craigyjp/PolyKit-16/photos/20230112_212233.jpg

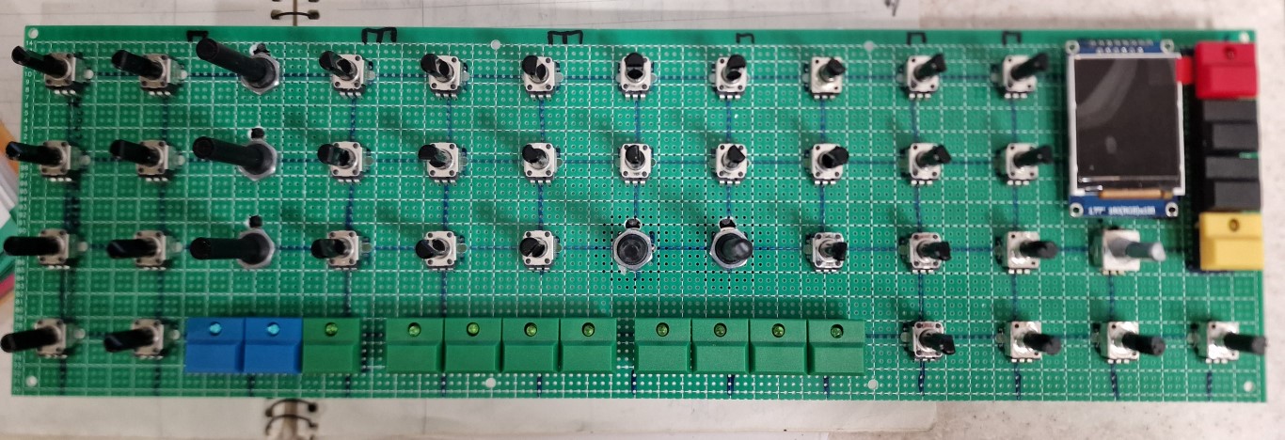
photos/20230112_212233.jpg
