craigyjp/PolyKit-16/photos/20230113_110707.jpg

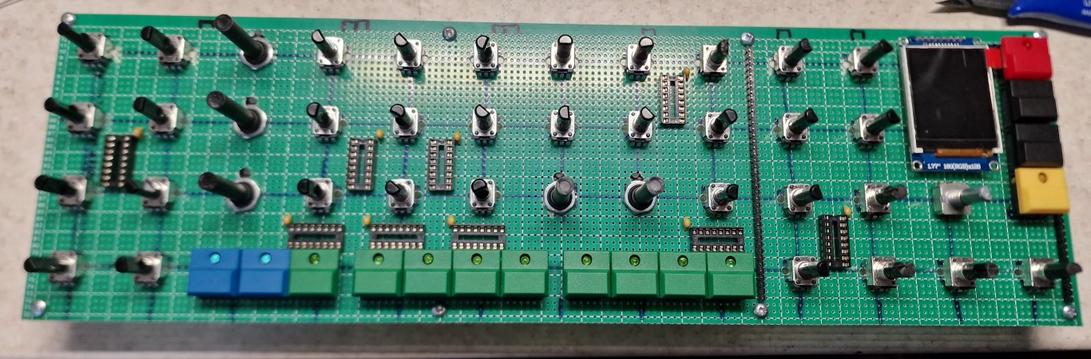
photos/20230113_110707.jpg
