craigyjp/PolyKit-16/photos/20230113_140341.jpg

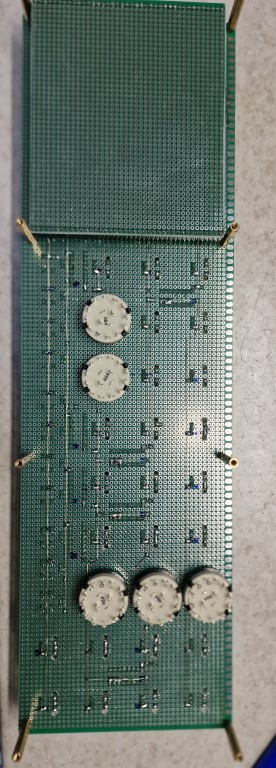
photos/20230113_140341.jpg
