craigyjp/PolyKit-16/photos/20230113_140354.jpg

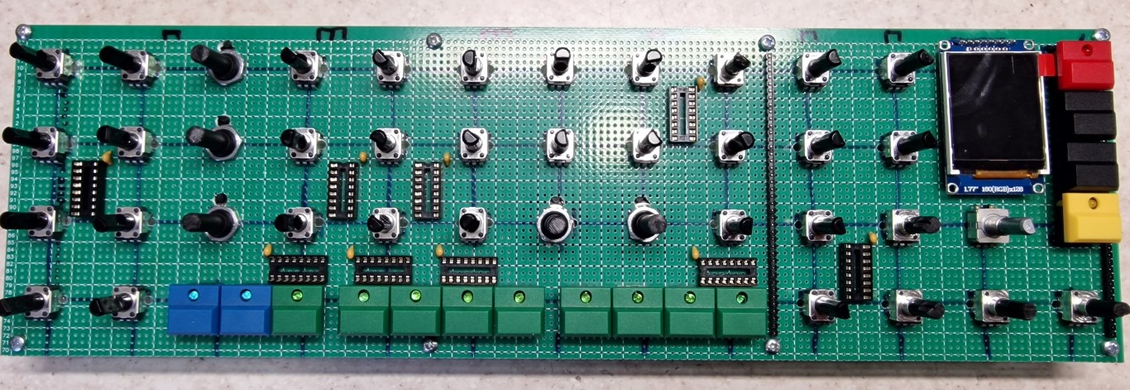
photos/20230113_140354.jpg
