craigyjp/PolyKit-16/photos/20230113_140404.jpg

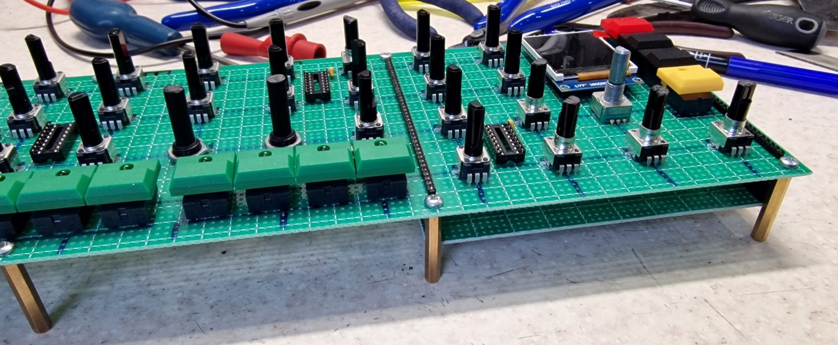
photos/20230113_140404.jpg
