craigyjp/PolyKit-16/photos/20230115_155945.jpg

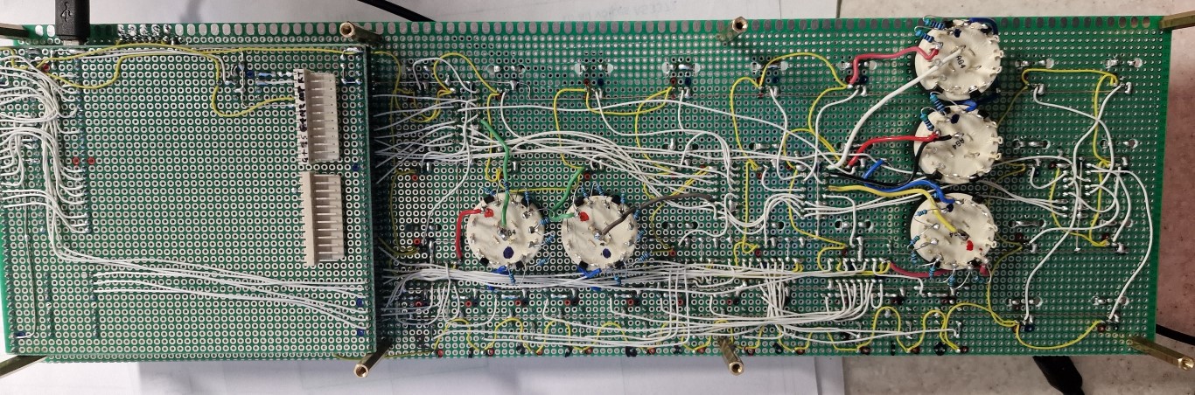
photos/20230115_155945.jpg
