craigyjp/PolyKit-16/photos/20230115_155958.jpg

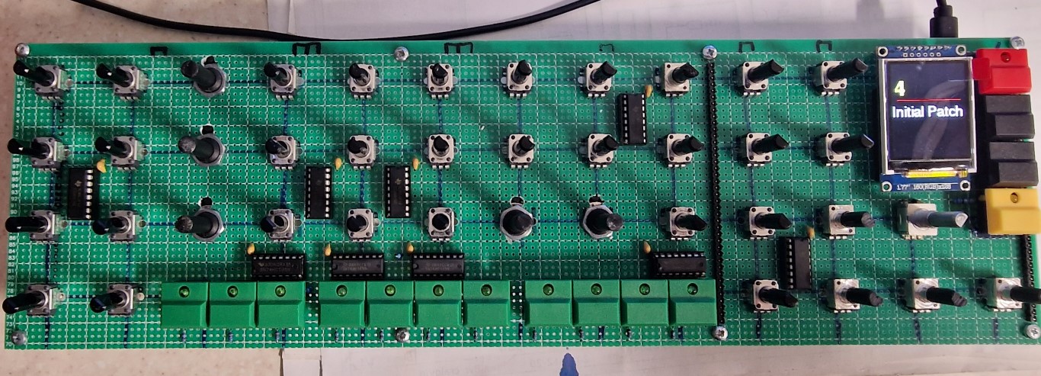
photos/20230115_155958.jpg
