craigyjp/PolyKit-16/photos/20230119_172531.jpg

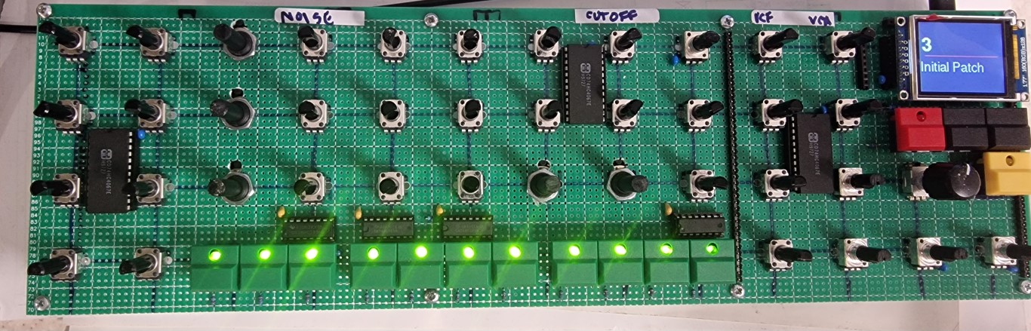
photos/20230119_172531.jpg
