craigyjp/PolyKit-16/photos/20230120_211841.jpg

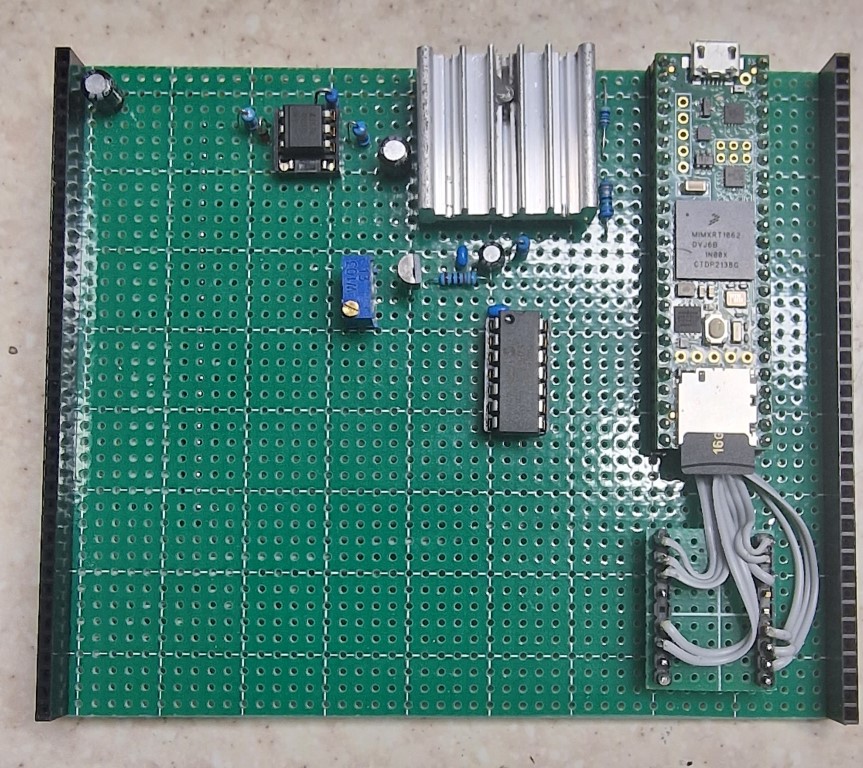
photos/20230120_211841.jpg
