craigyjp/PolyKit-16/photos/20230121_161446.jpg

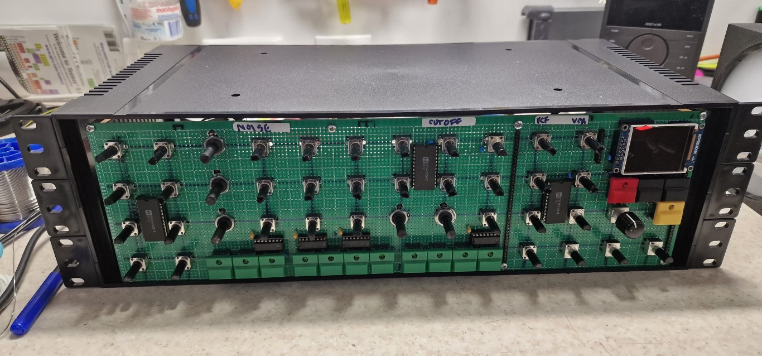
photos/20230121_161446.jpg
