craigyjp/PolyKit-16/photos/20230121_161559.jpg

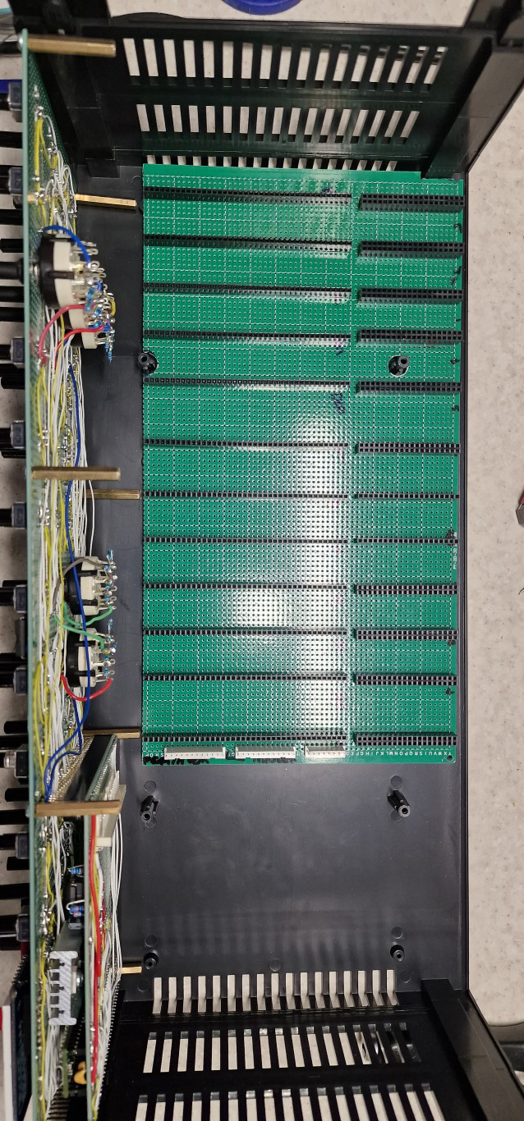
photos/20230121_161559.jpg
