craigyjp/PolyKit-16/photos/20230121_221155.jpg

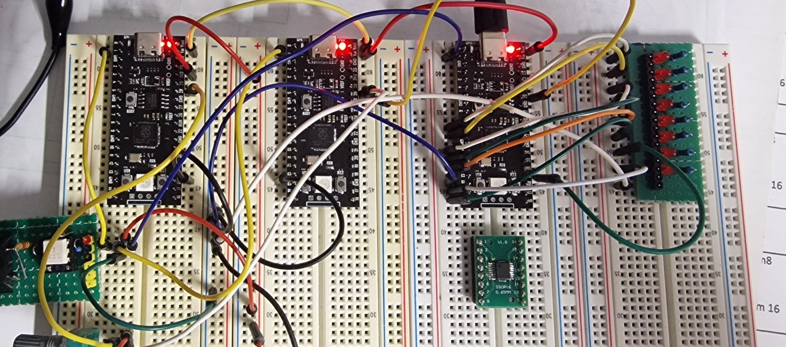
photos/20230121_221155.jpg
