craigyjp/PolyKit-16/photos/20230122_144658.jpg

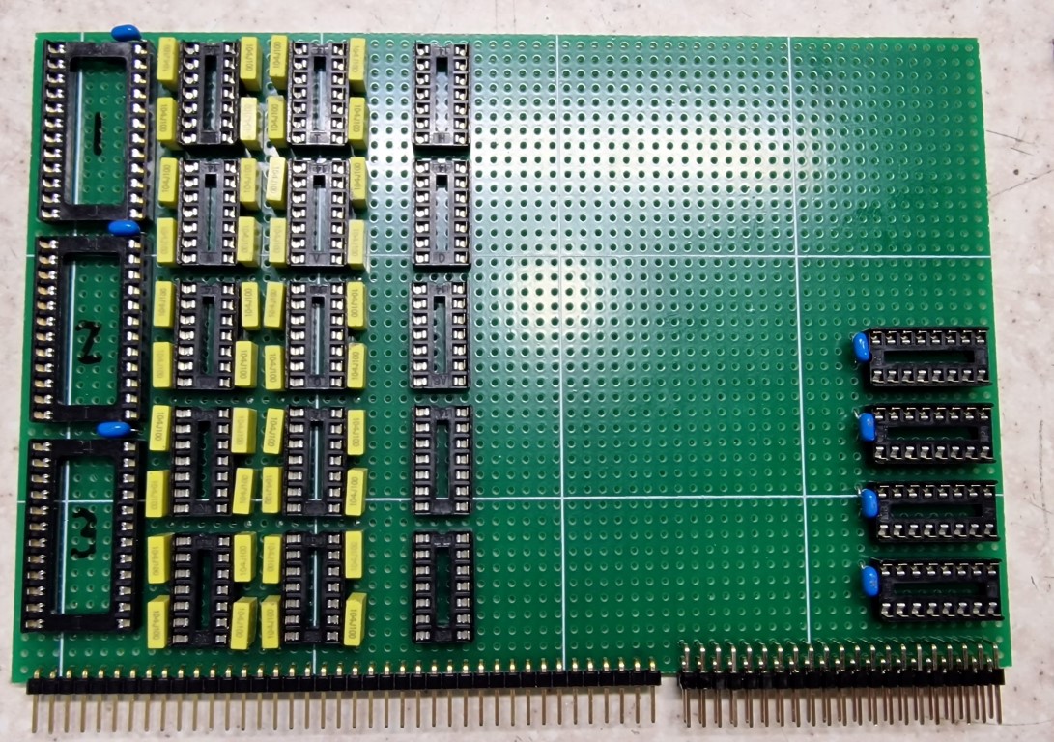
photos/20230122_144658.jpg
