craigyjp/PolyKit-16/photos/20230122_203301.jpg

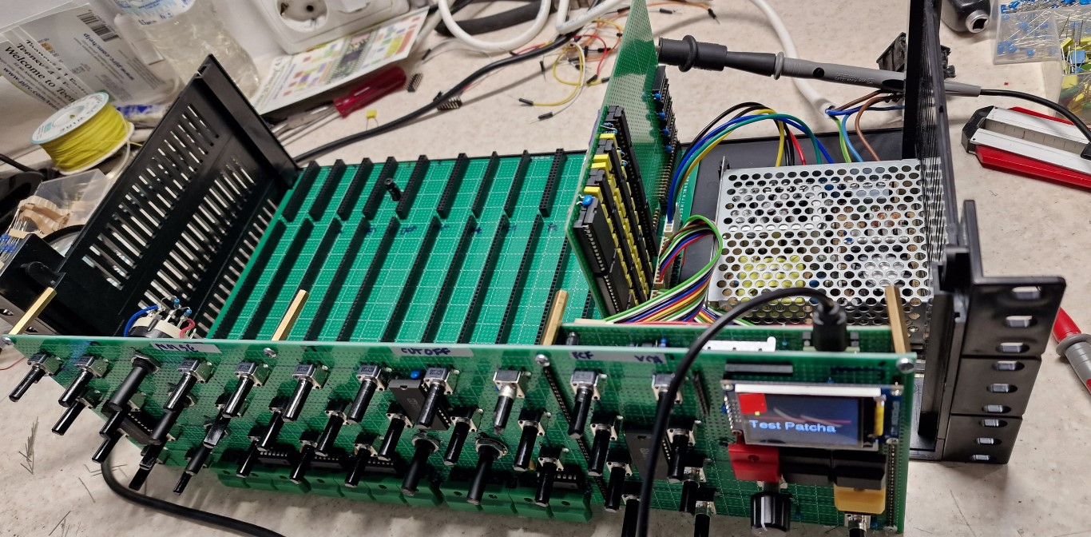
photos/20230122_203301.jpg
