craigyjp/PolyKit-16/photos/20230123_171128.jpg

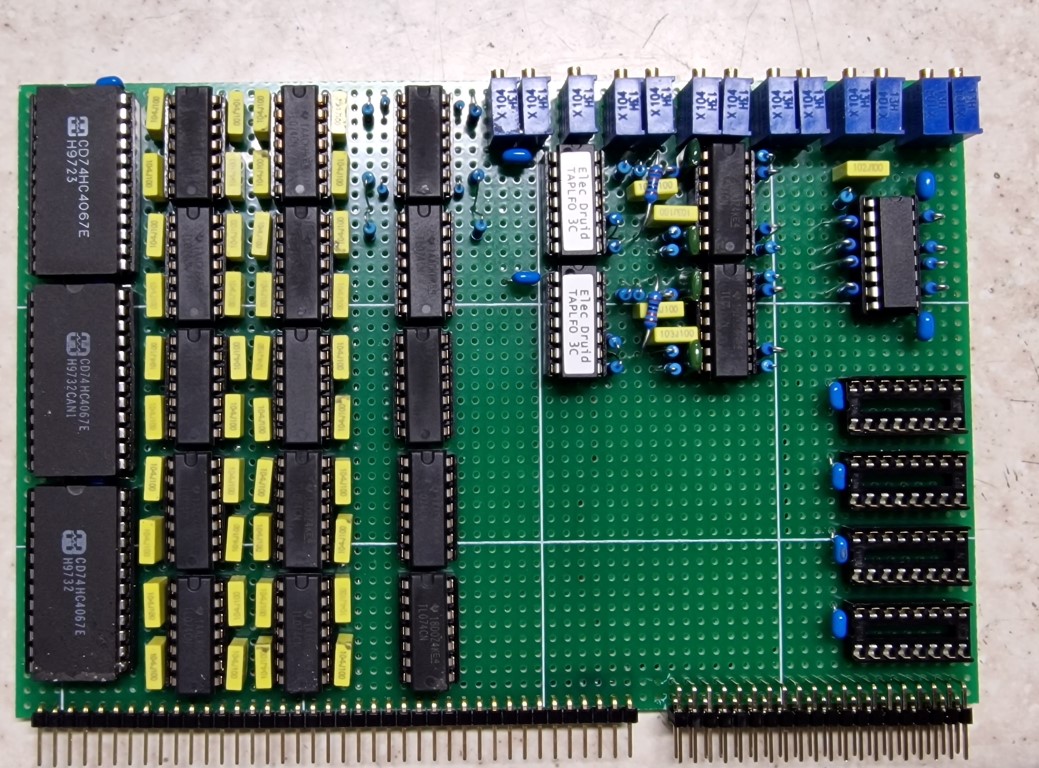
photos/20230123_171128.jpg
