craigyjp/PolyKit-16/photos/20230123_171157.jpg

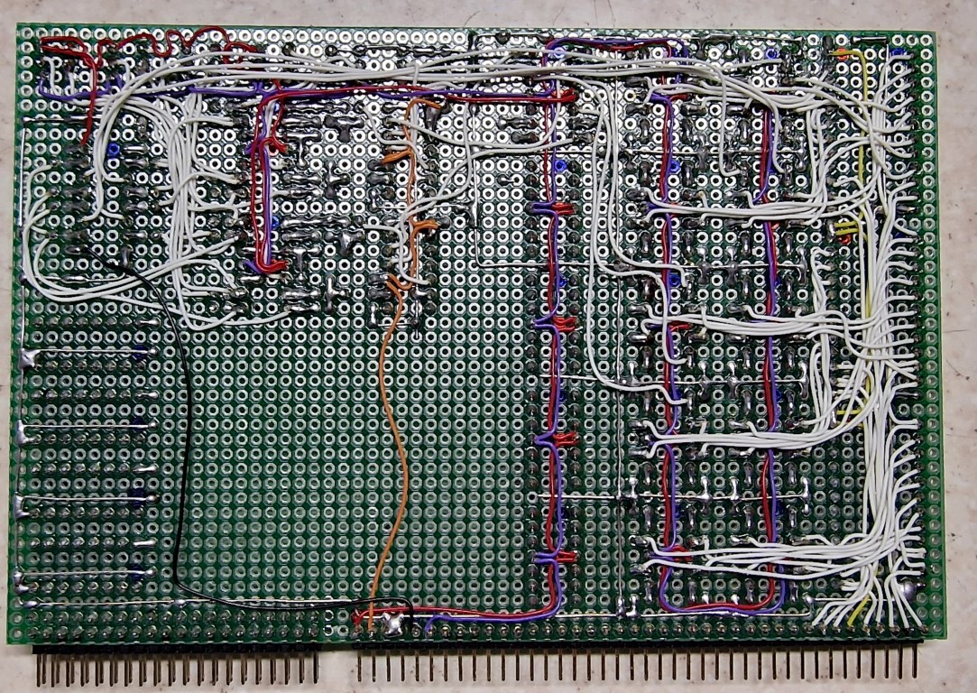
photos/20230123_171157.jpg
