craigyjp/PolyKit-16/photos/20230123_195308.jpg

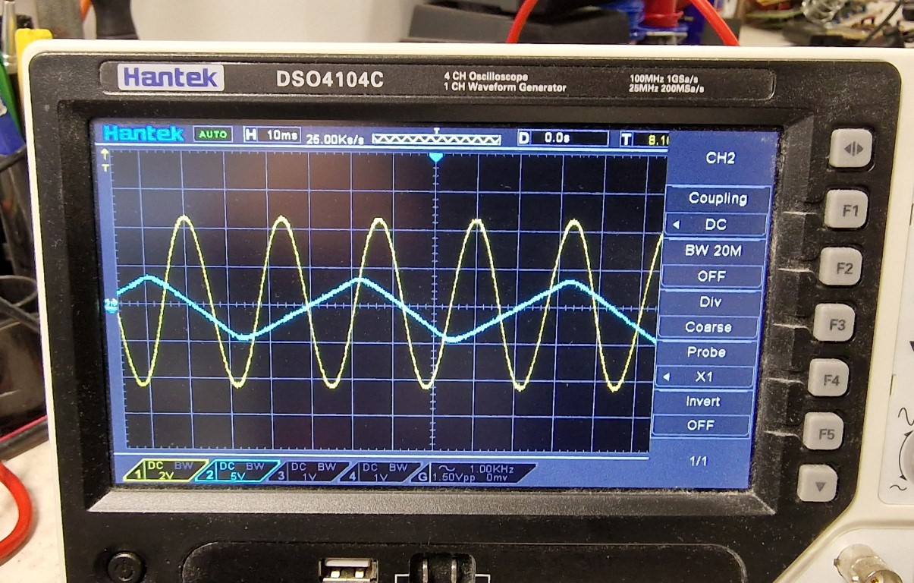
photos/20230123_195308.jpg
