craigyjp/PolyKit-16/photos/20230123_204247.jpg

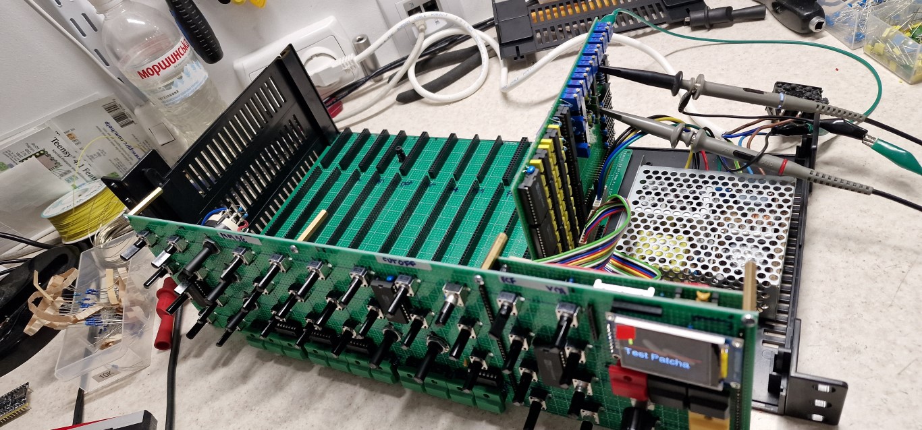
photos/20230123_204247.jpg
