craigyjp/PolyKit-16/photos/20230123_204253.jpg

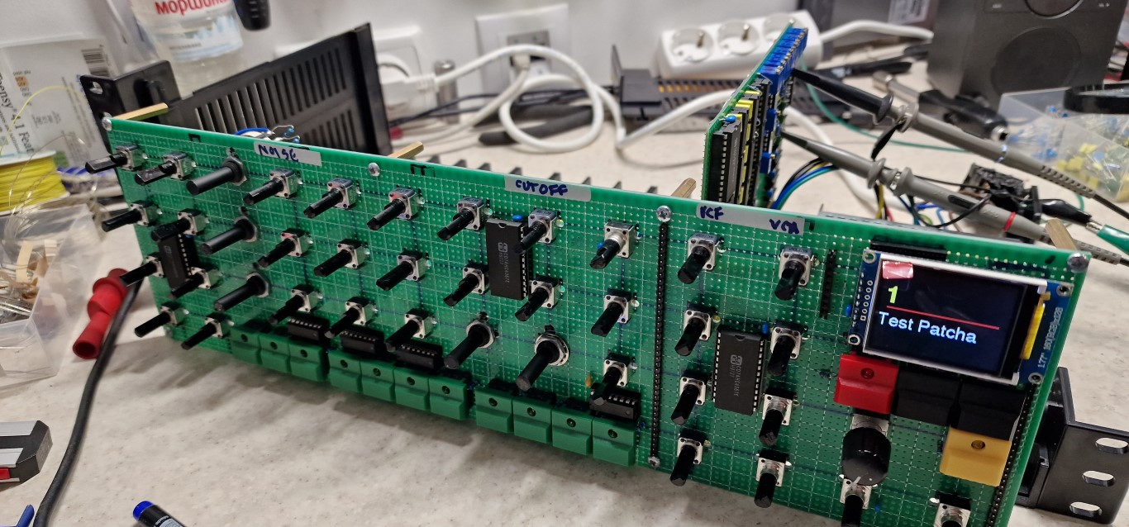
photos/20230123_204253.jpg
