craigyjp/PolyKit-16/photos/20230124_180600.jpg

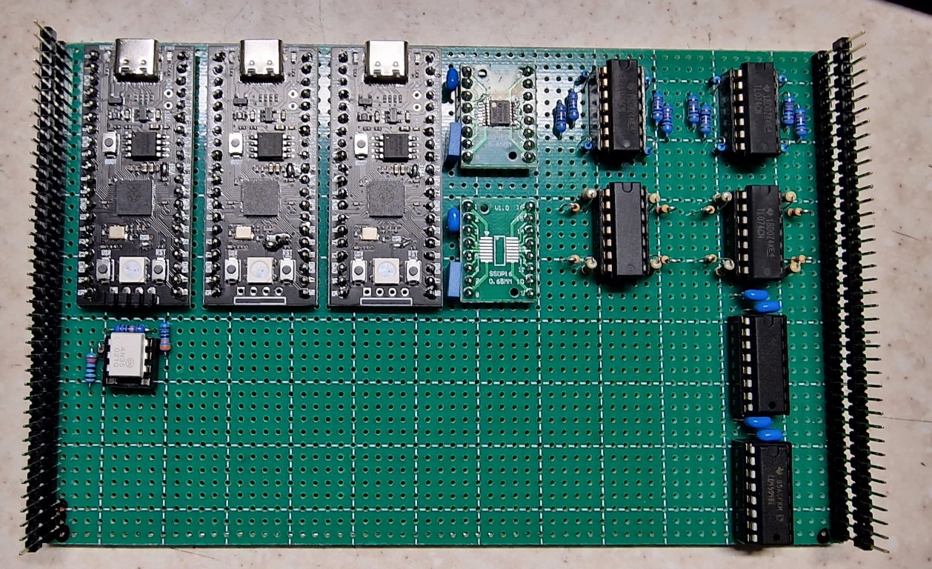
photos/20230124_180600.jpg
