craigyjp/PolyKit-16/photos/20230124_181016.jpg

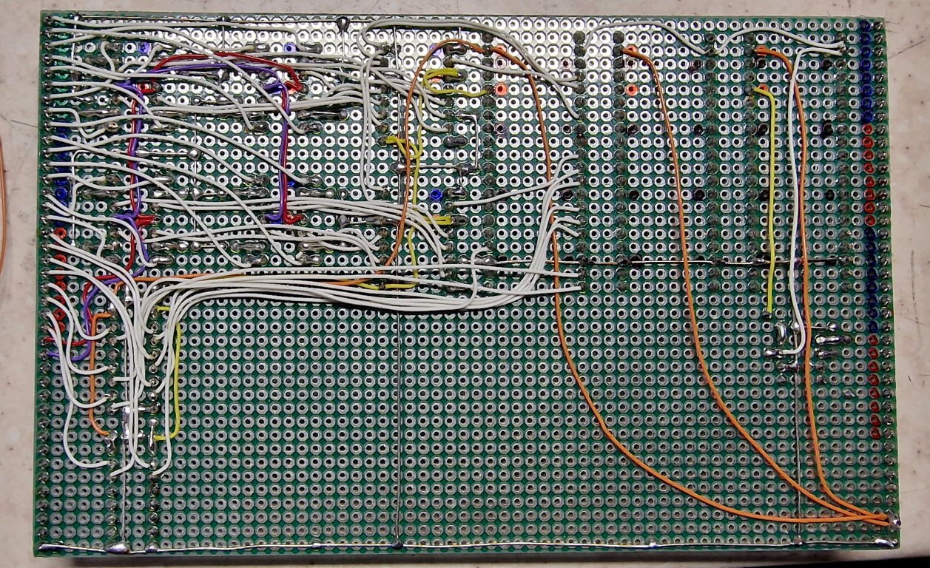
photos/20230124_181016.jpg
