craigyjp/PolyKit-16/photos/20230125_140616.jpg

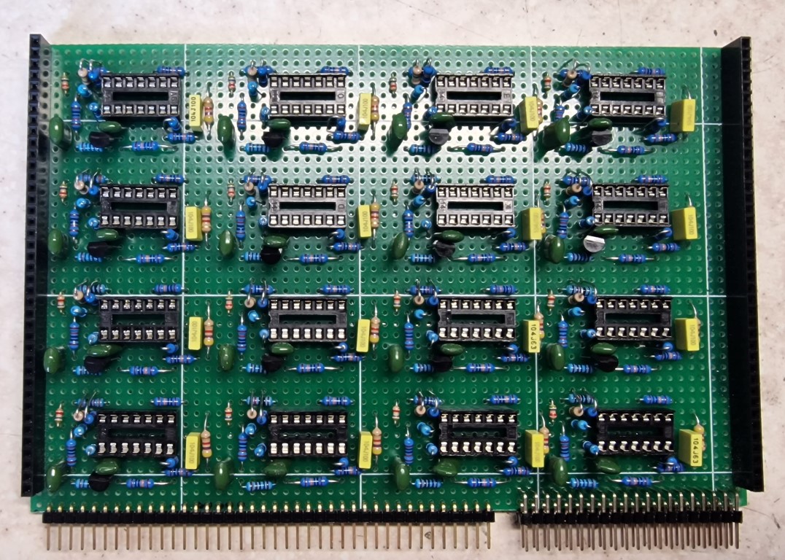
photos/20230125_140616.jpg
