craigyjp/PolyKit-16/photos/20230125_140625.jpg

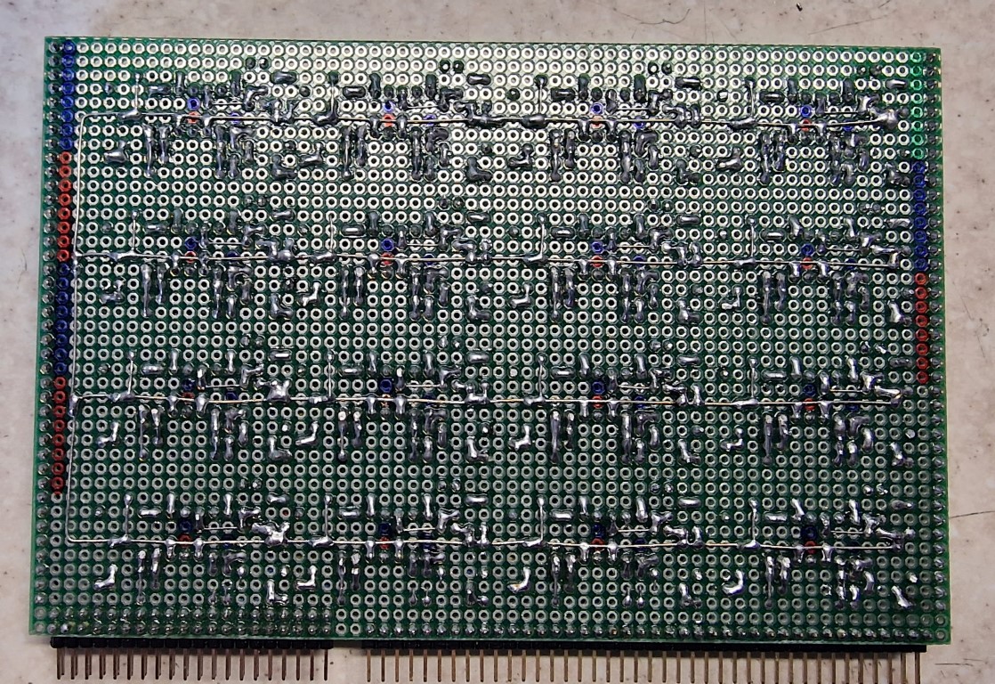
photos/20230125_140625.jpg
