craigyjp/PolyKit-16/photos/20230125_160724.jpg

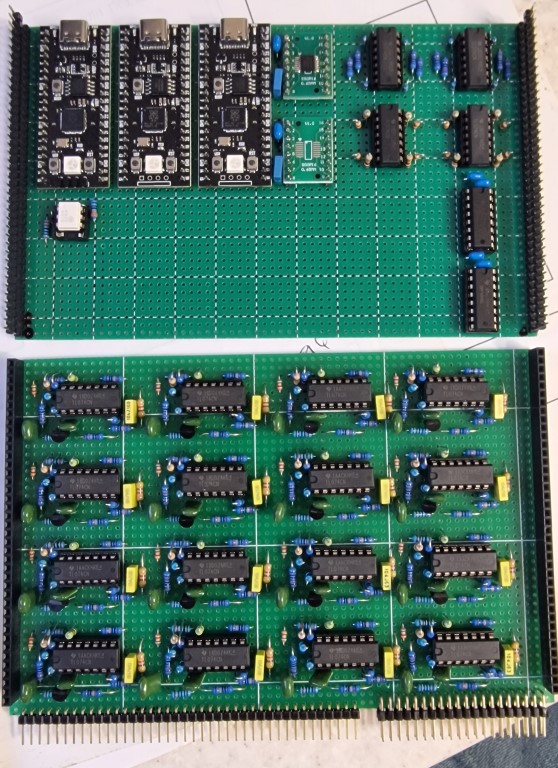
photos/20230125_160724.jpg
