craigyjp/PolyKit-16/photos/20230125_203501.jpg

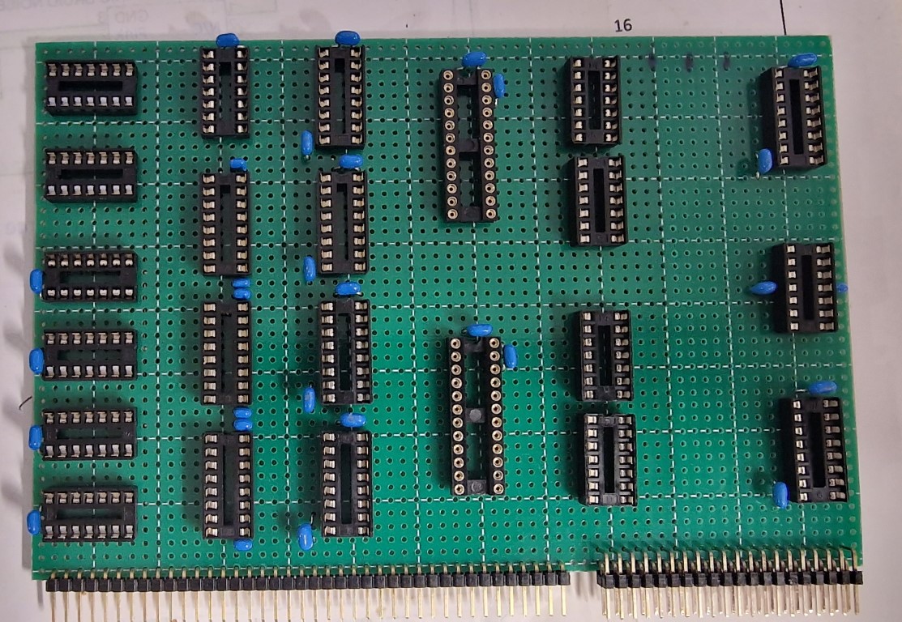
photos/20230125_203501.jpg
