craigyjp/PolyKit-16/photos/20230126_164155.jpg

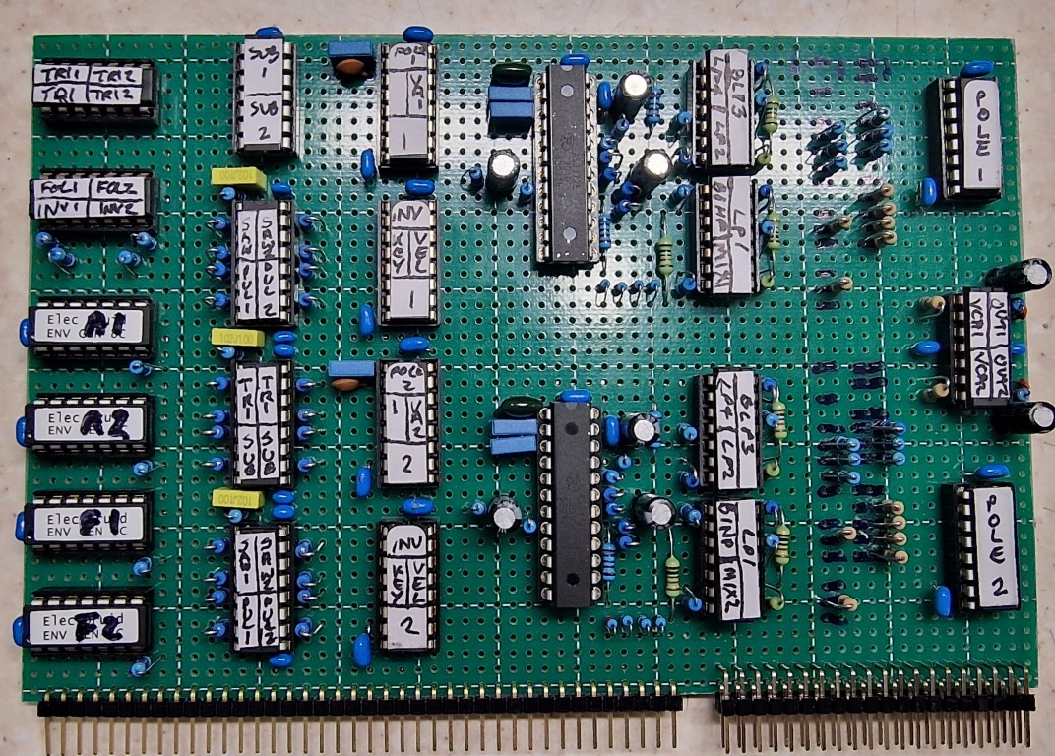
photos/20230126_164155.jpg
