craigyjp/PolyKit-16/photos/20230129_130145.jpg

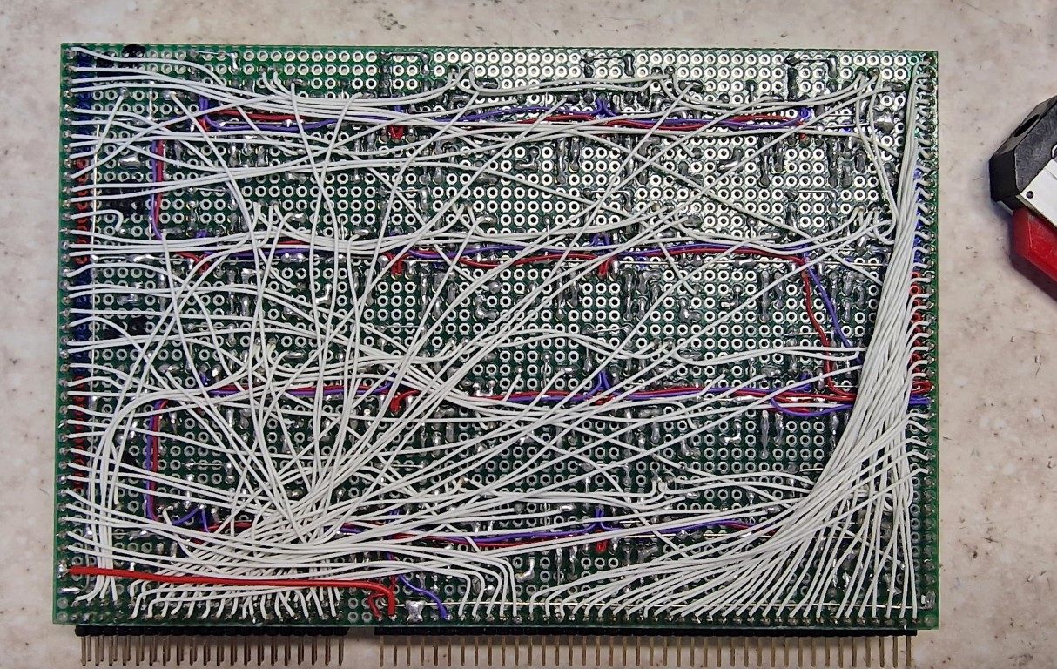
photos/20230129_130145.jpg
