craigyjp/PolyKit-16/photos/20230129_132823.jpg

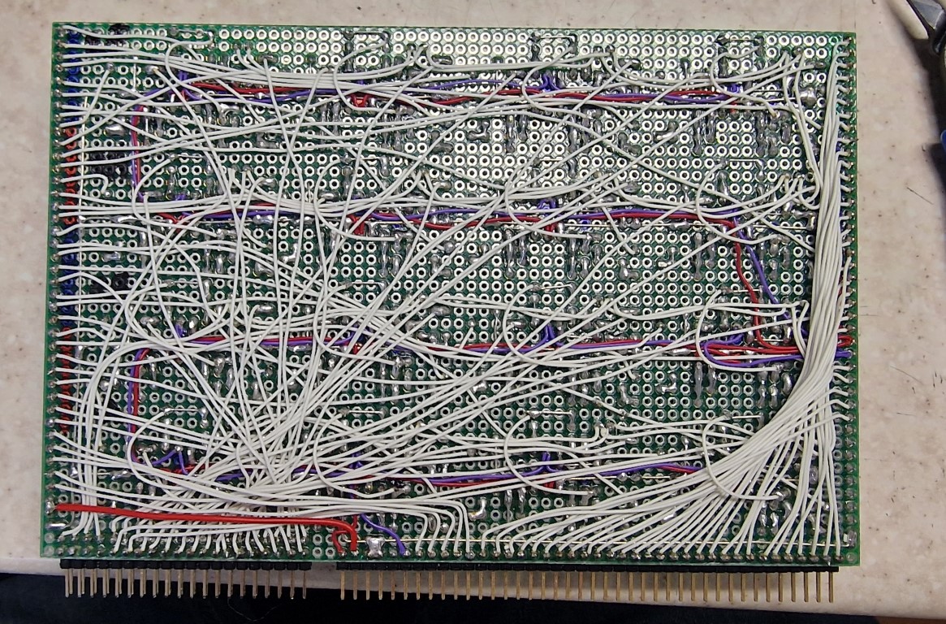
photos/20230129_132823.jpg
