craigyjp/PolyKit-16/photos/20230129_185415.jpg

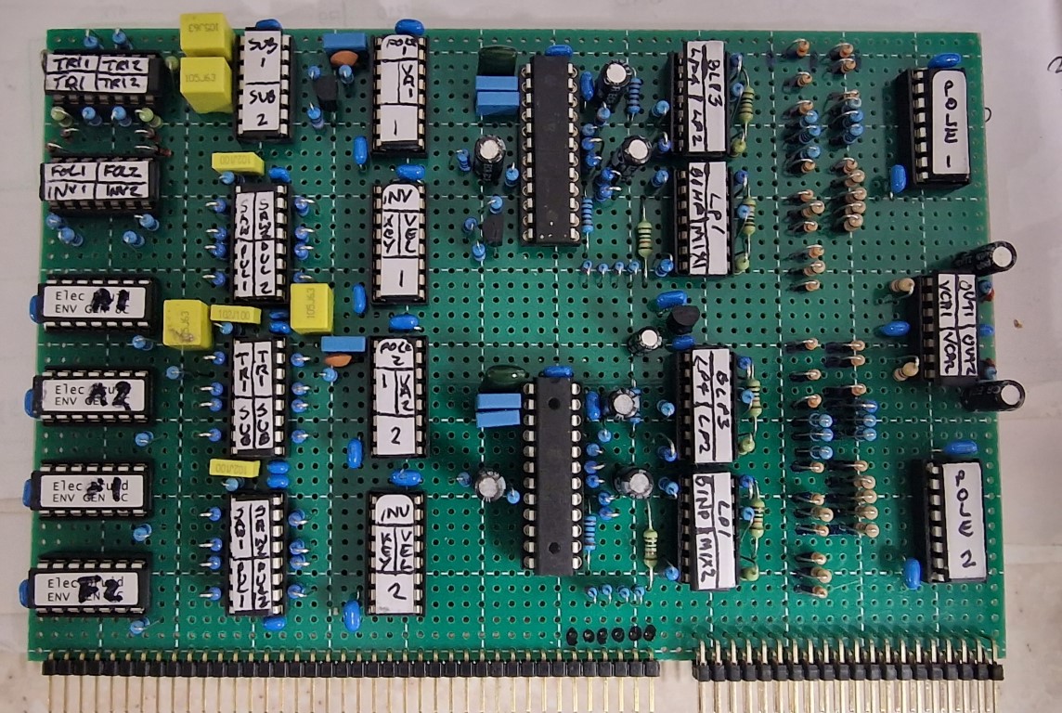
photos/20230129_185415.jpg
