craigyjp/PolyKit-16/photos/20230129_185424.jpg

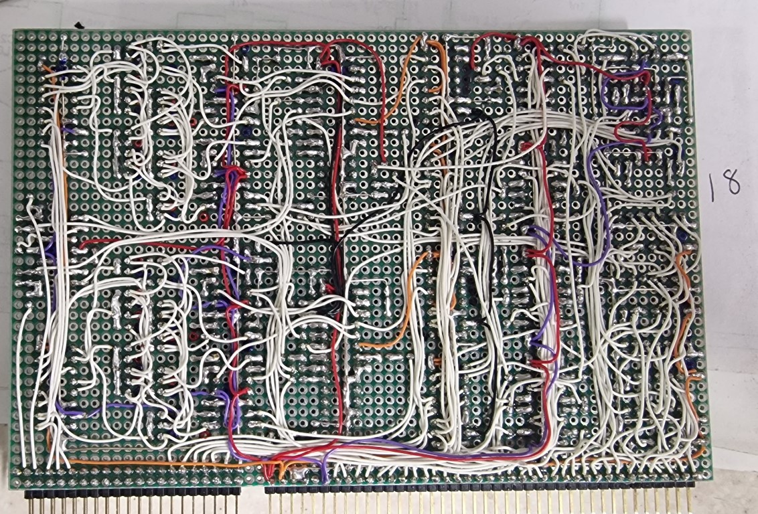
photos/20230129_185424.jpg
