craigyjp/PolyKit-16/photos/20230129_200219.jpg

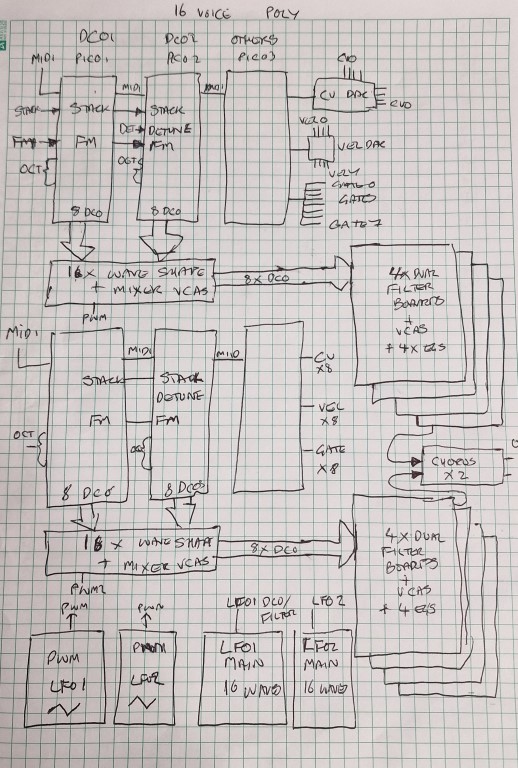
photos/20230129_200219.jpg
