craigyjp/PolyKit-16/photos/20230201_124814.jpg

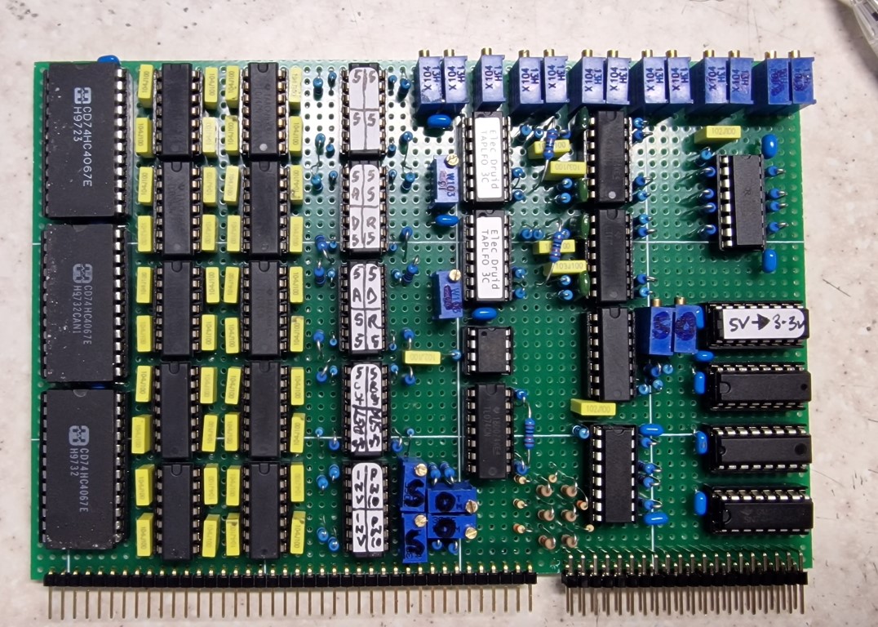
photos/20230201_124814.jpg
