craigyjp/PolyKit-16/photos/20230201_124823.jpg

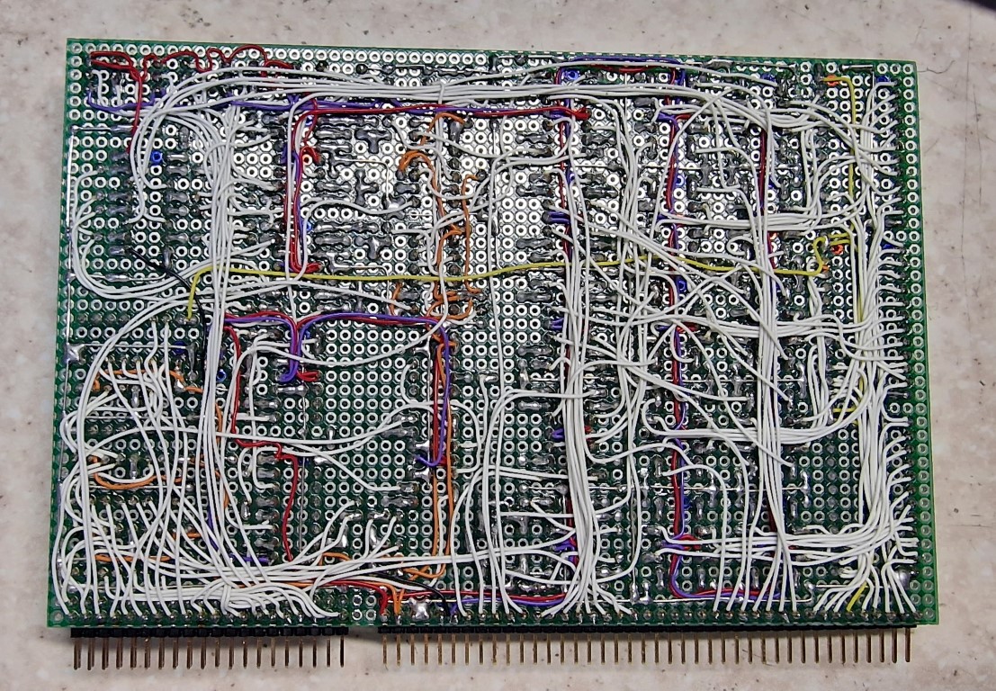
photos/20230201_124823.jpg
