craigyjp/PolyKit-16/photos/20230201_231255.jpg

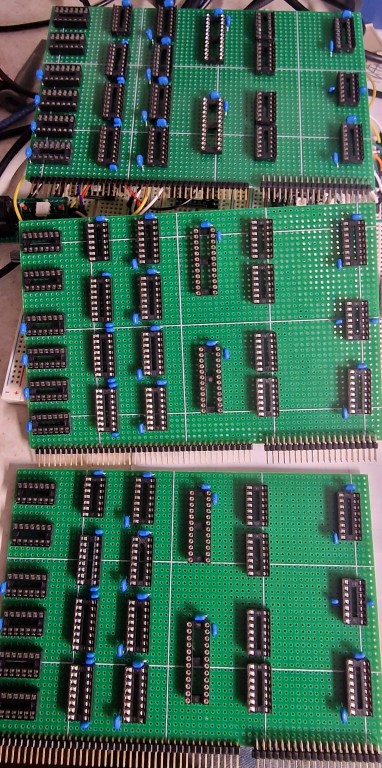
photos/20230201_231255.jpg
