craigyjp/PolyKit-16/photos/20230202_223132.jpg

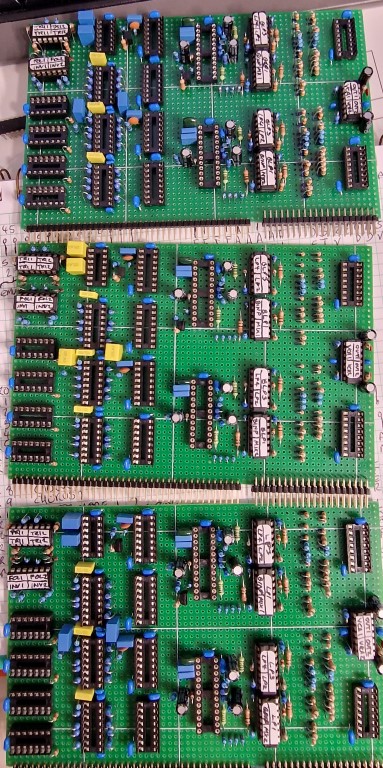
photos/20230202_223132.jpg
