craigyjp/PolyKit-16/photos/20230203_212551.jpg

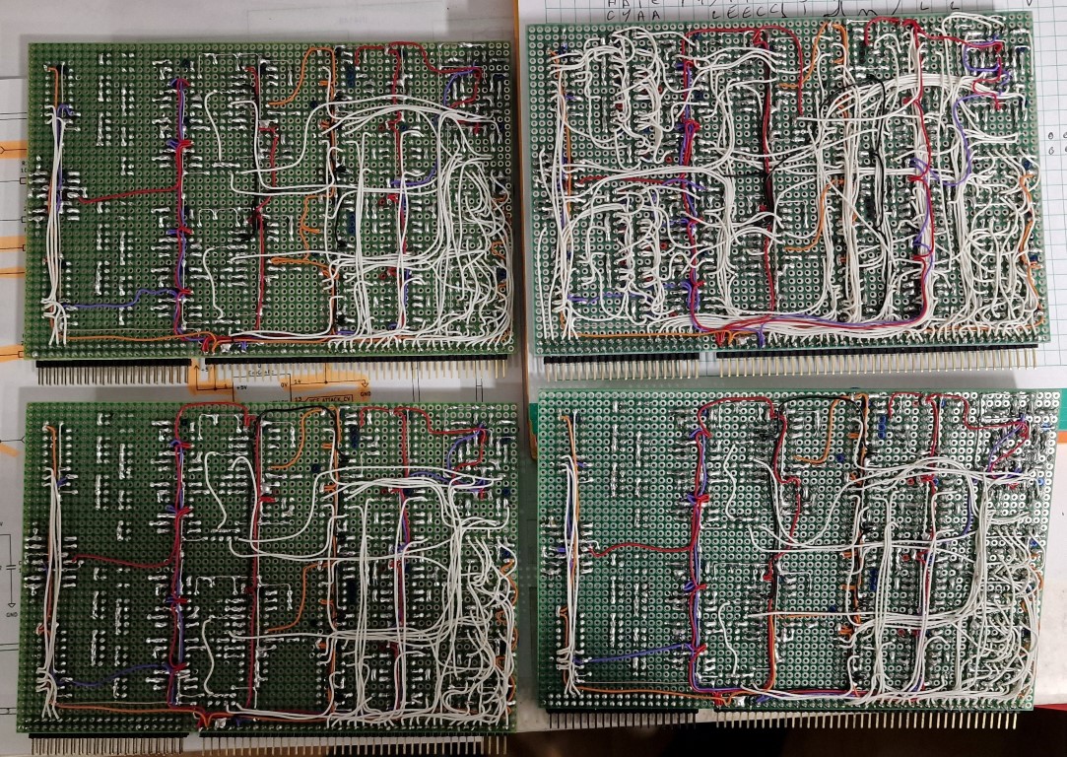
photos/20230203_212551.jpg
