craigyjp/PolyKit-16/photos/20230205_132014.jpg

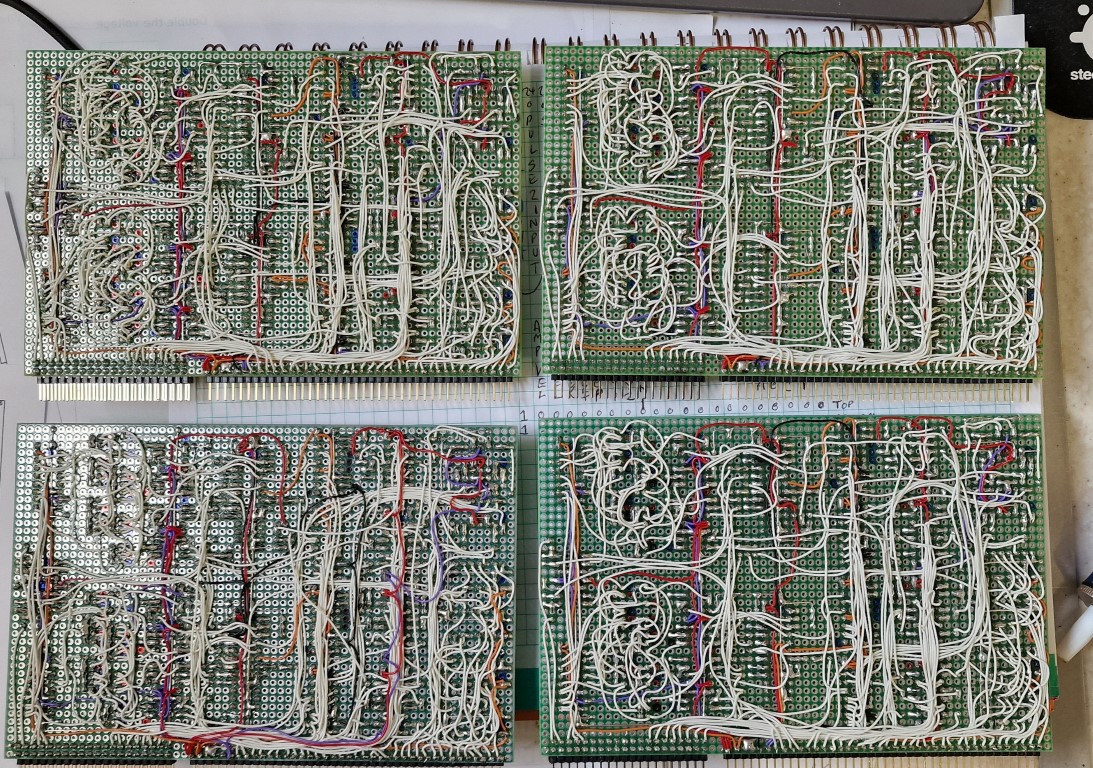
photos/20230205_132014.jpg
