craigyjp/PolyKit-16/photos/20230205_132043.jpg

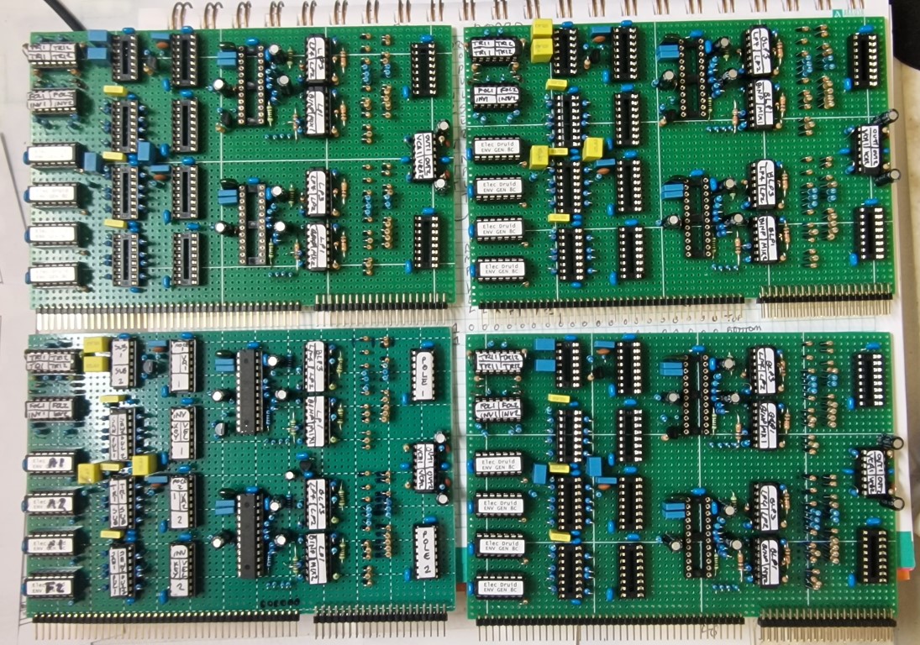
photos/20230205_132043.jpg
