craigyjp/PolyKit-16/Schematics/VCAs and Wave Converters.pdf

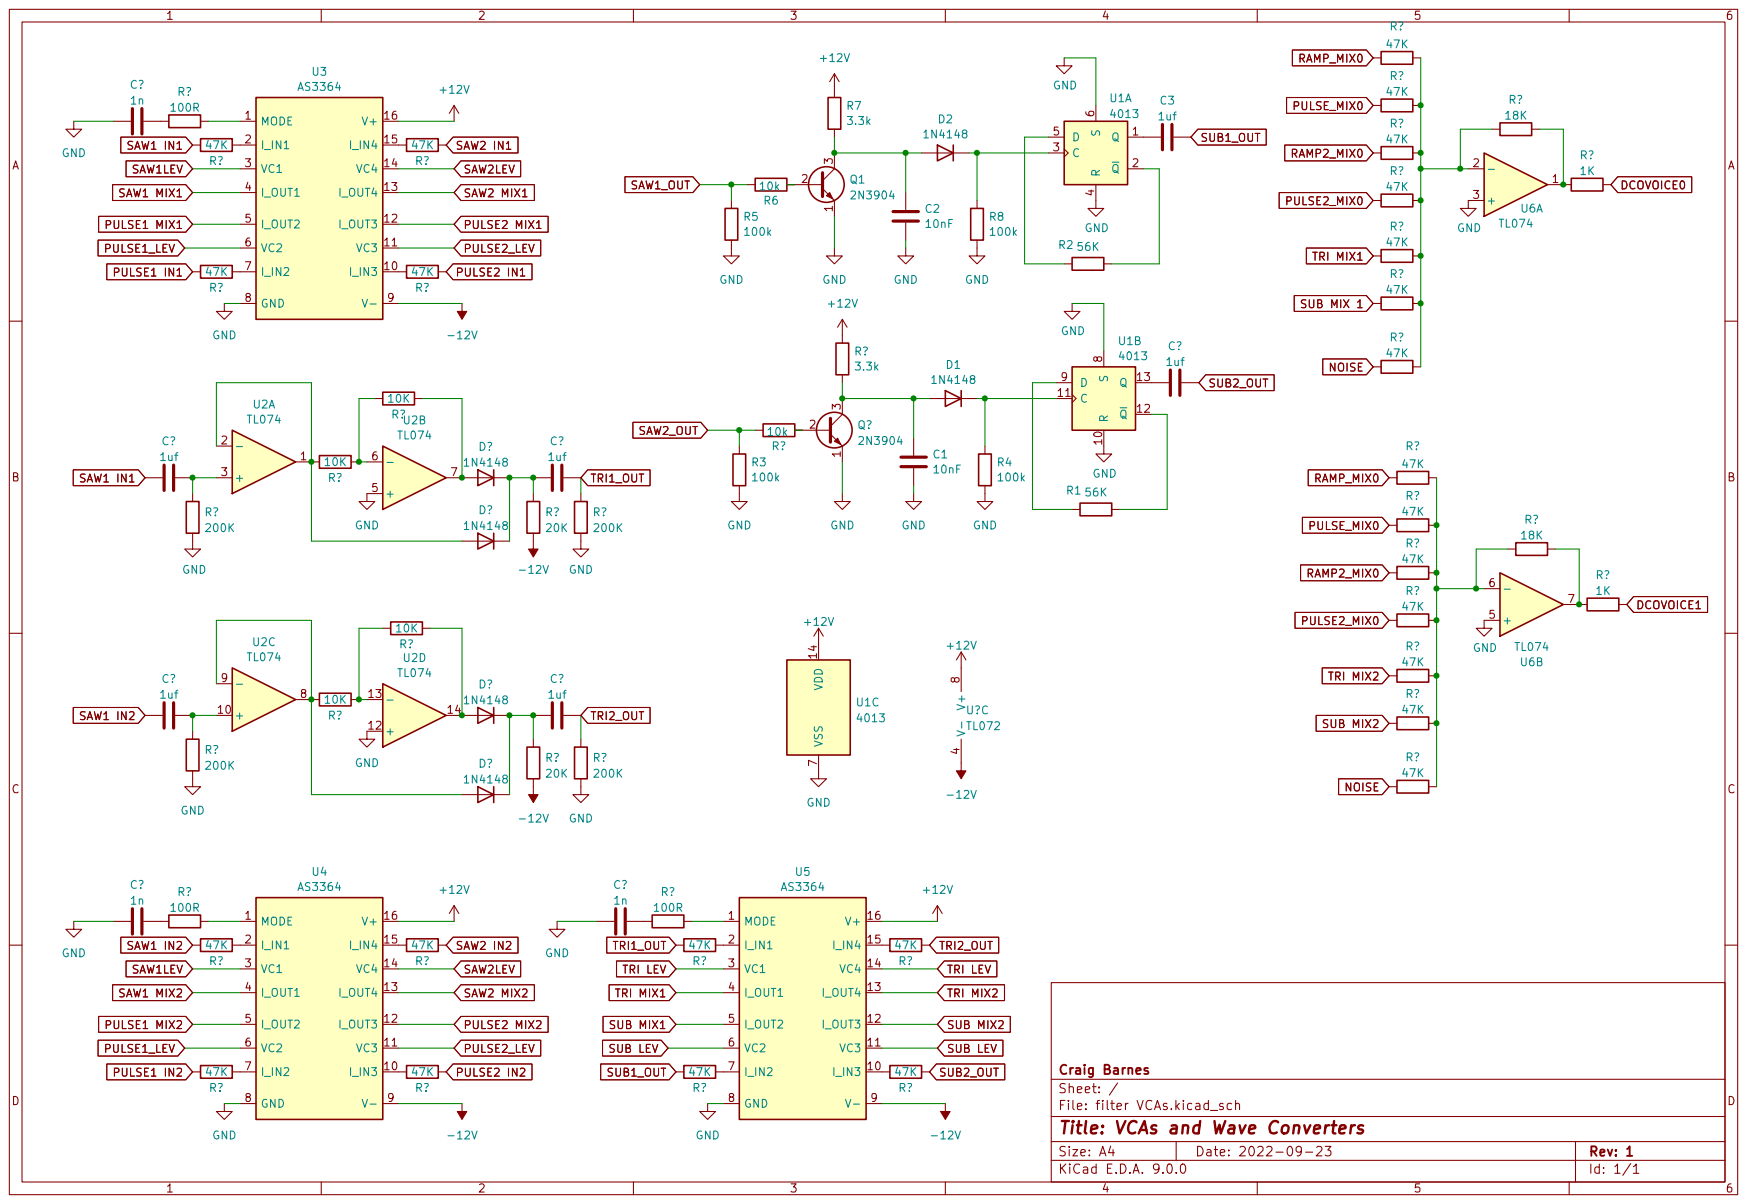
[picture p40: page 1]
