craigyjp/PolyKit-16/Schematics/demux.pdf

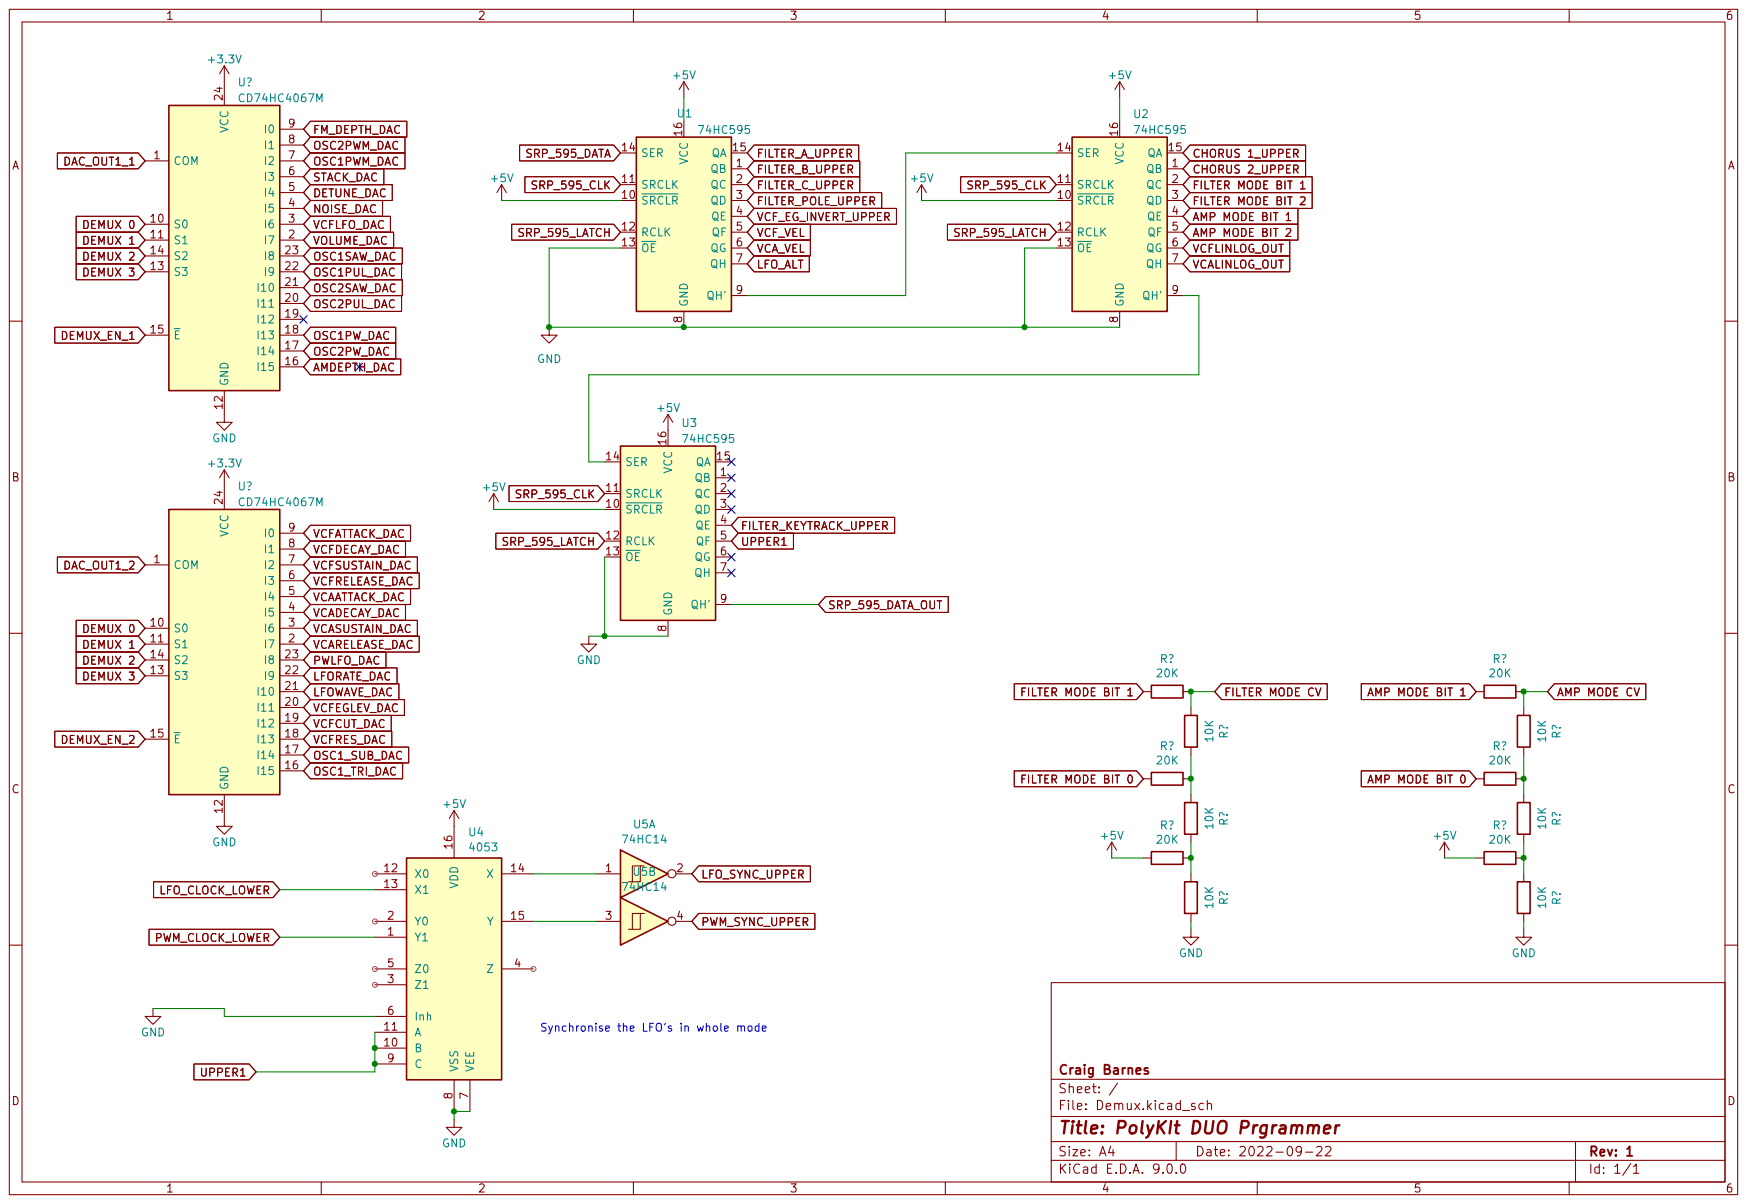
[picture p41: page 1]
