craigyjp/PolyKit-16/Schematics/front panel pots.pdf

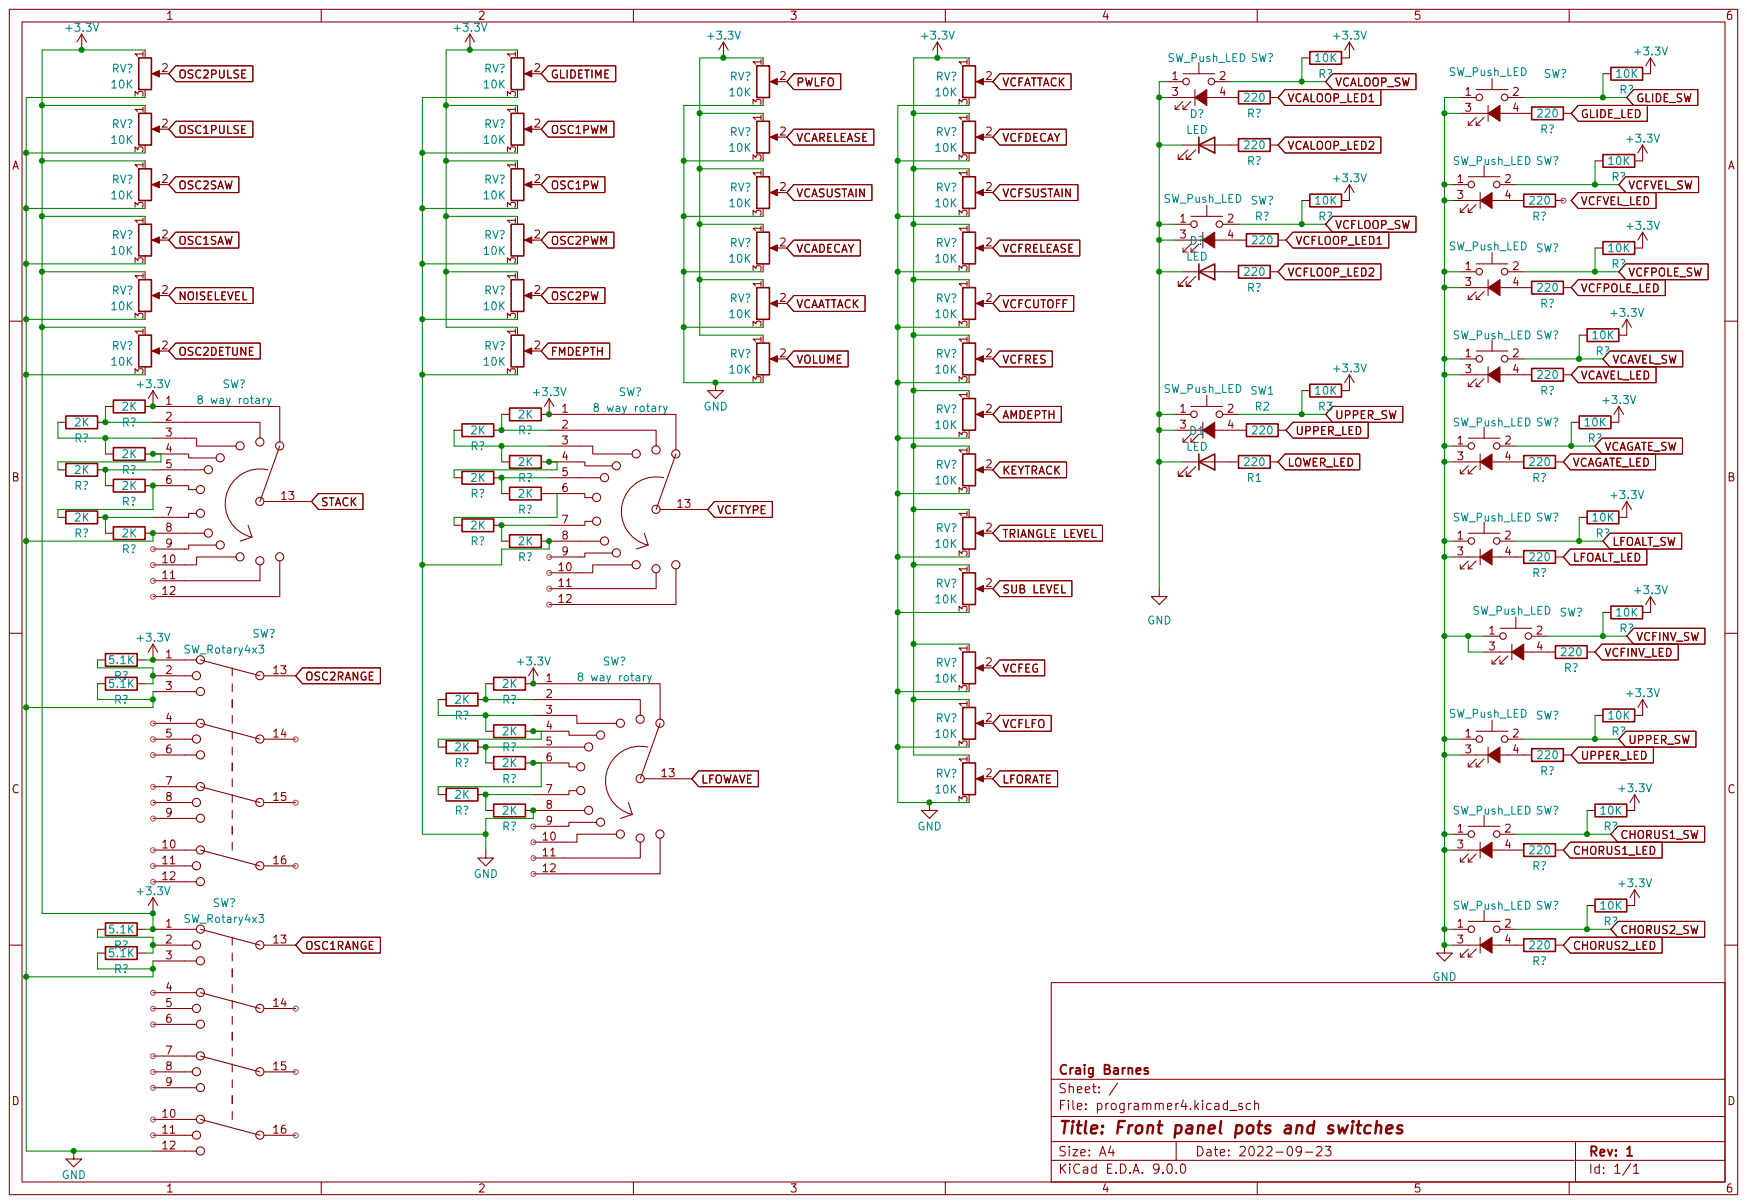
[picture p42: page 1]
