craigyjp/PolyKit-16/Schematics/LFO_VCA.pdf

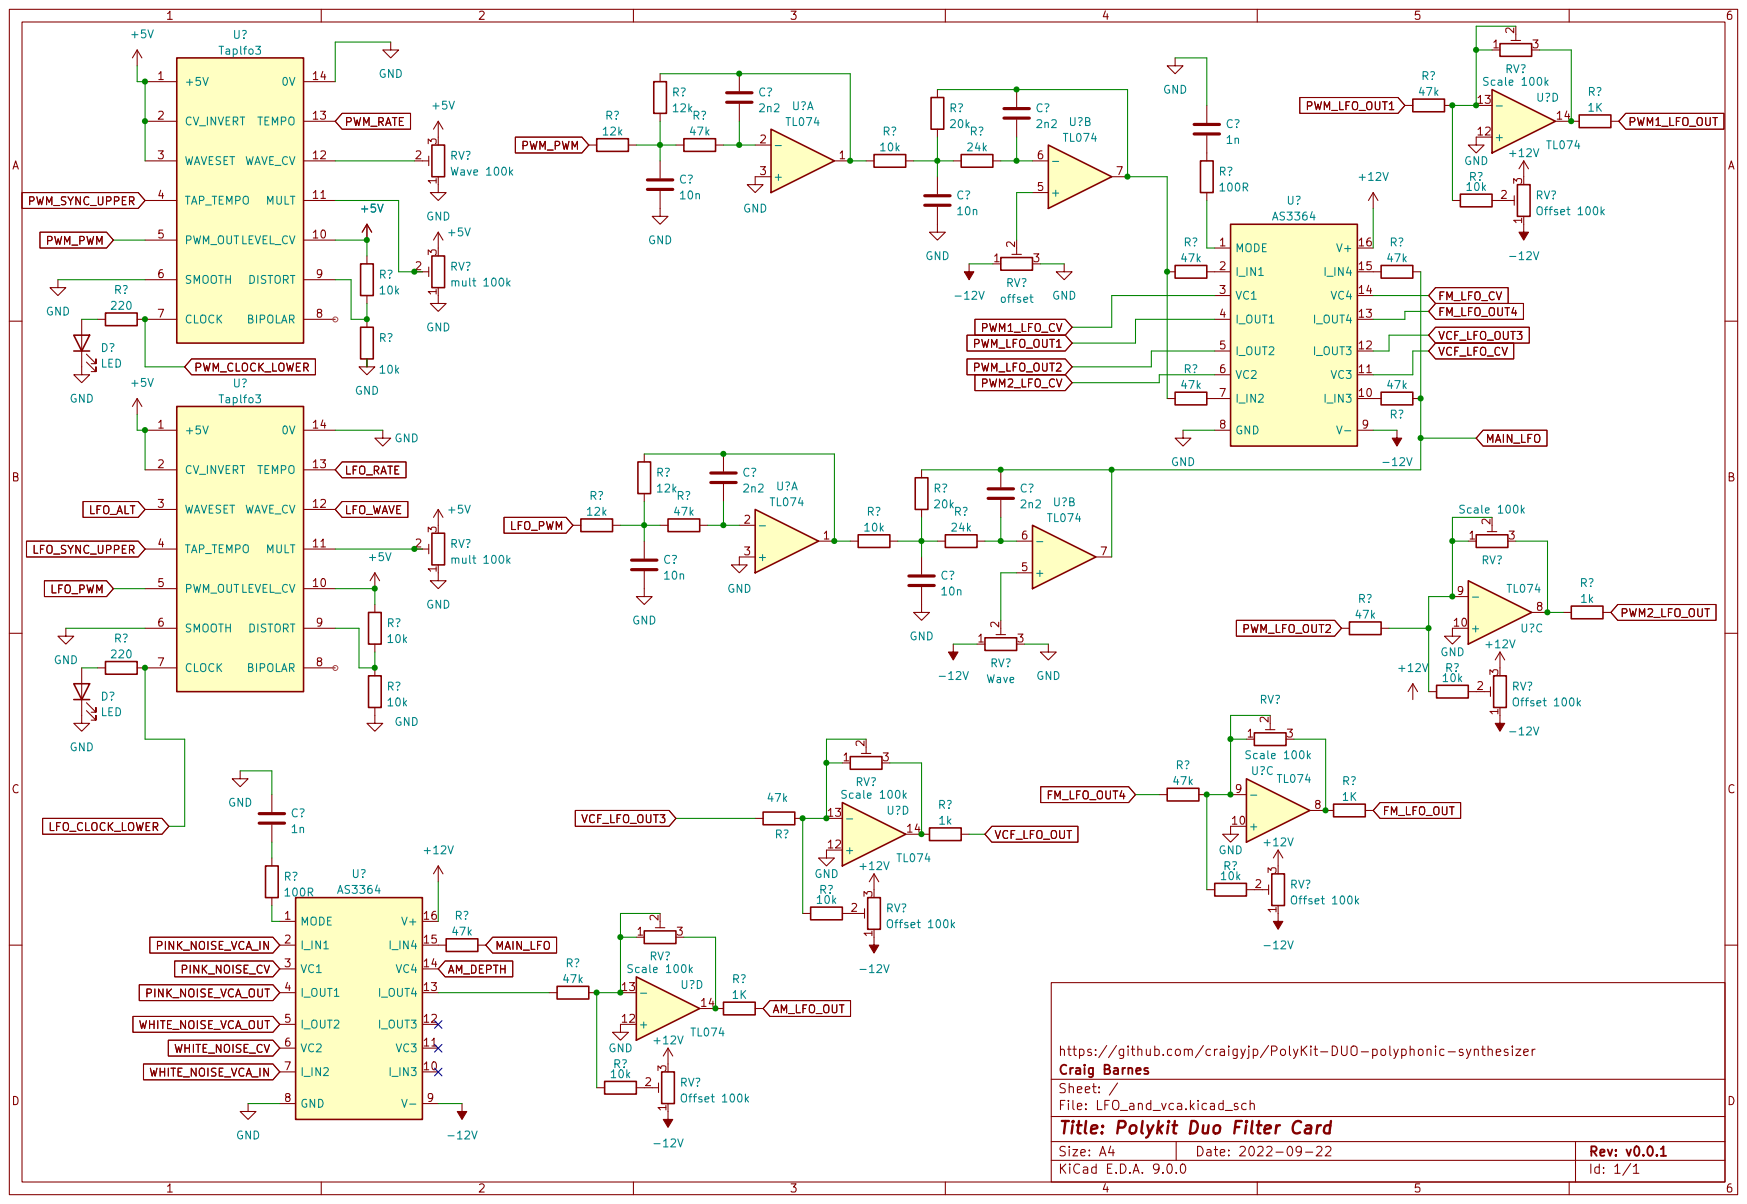
[picture p43: page 1]
