craigyjp/PolyKit-16/Schematics/teensyboard.pdf

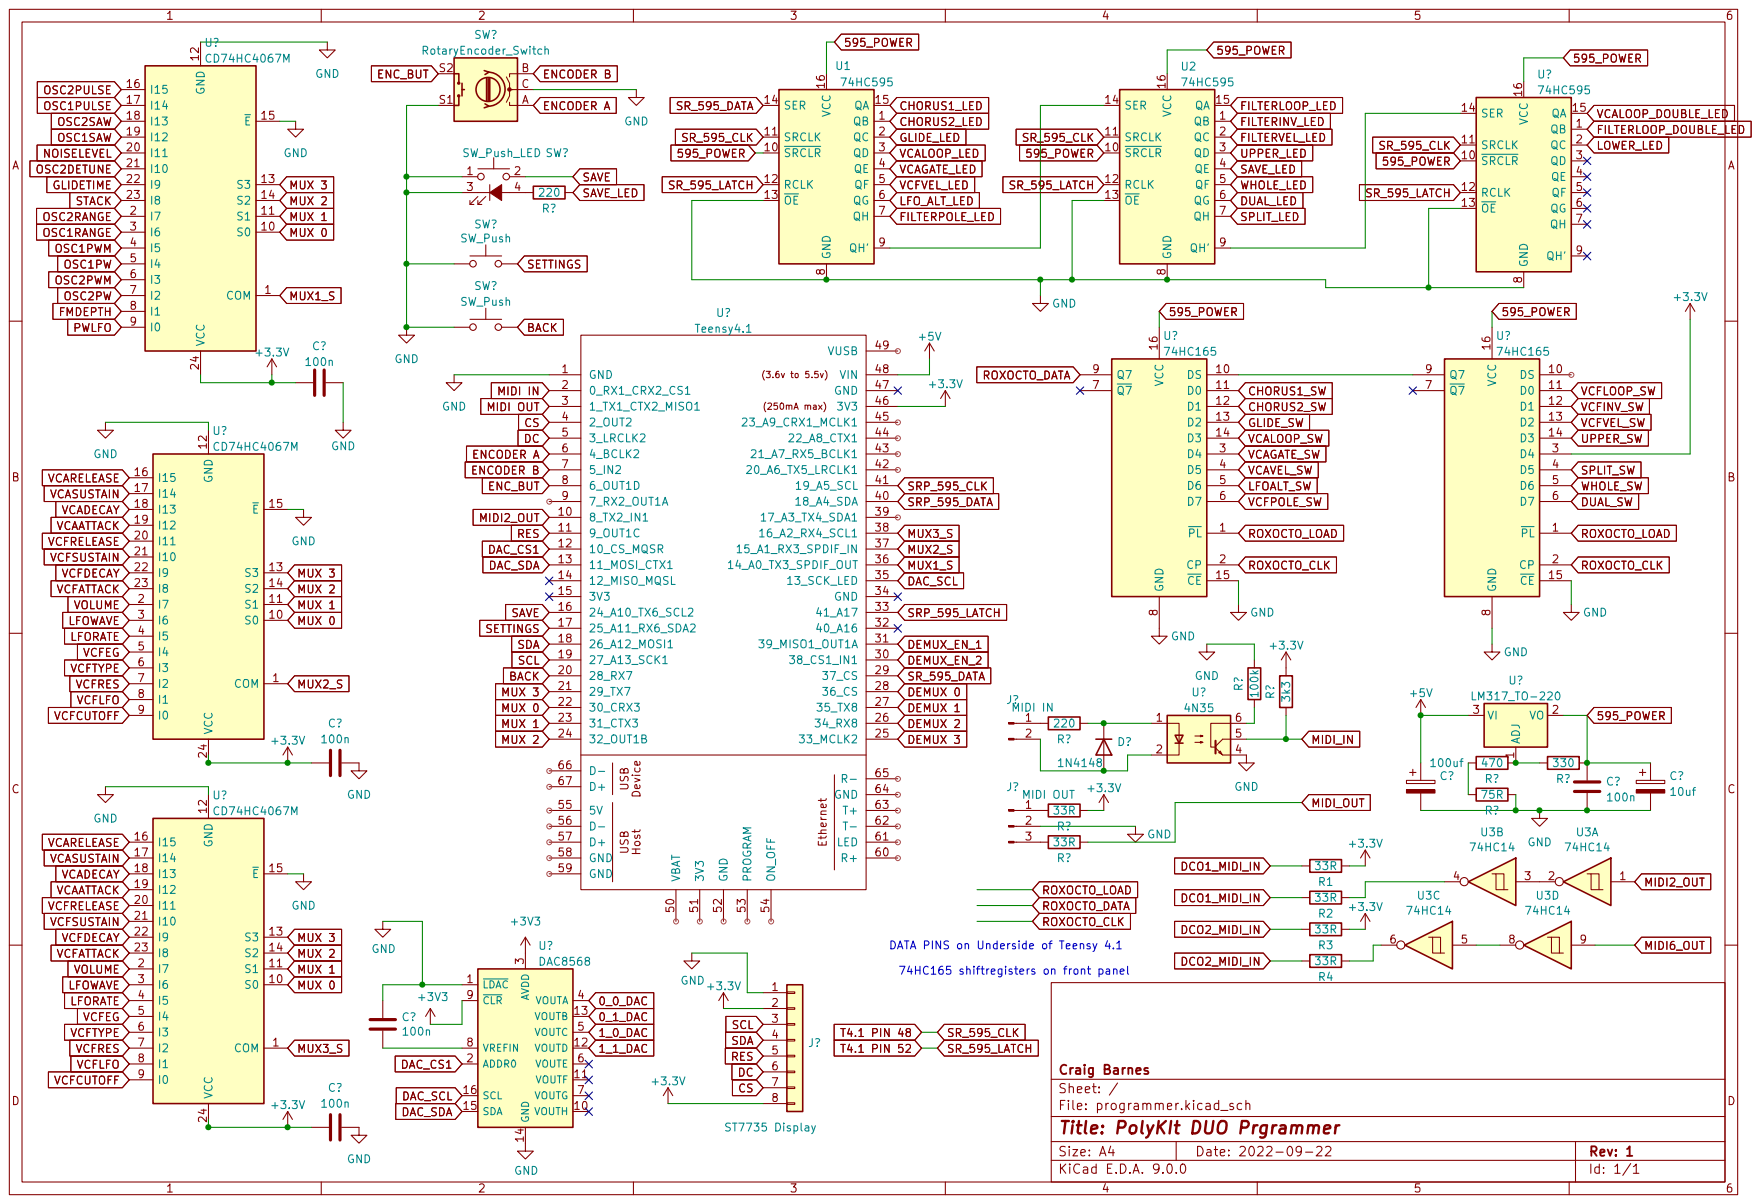
[picture p44: page 1]
