craigyjp/PolyKit-16/Schematics/YD-pico-dco-board.pdf

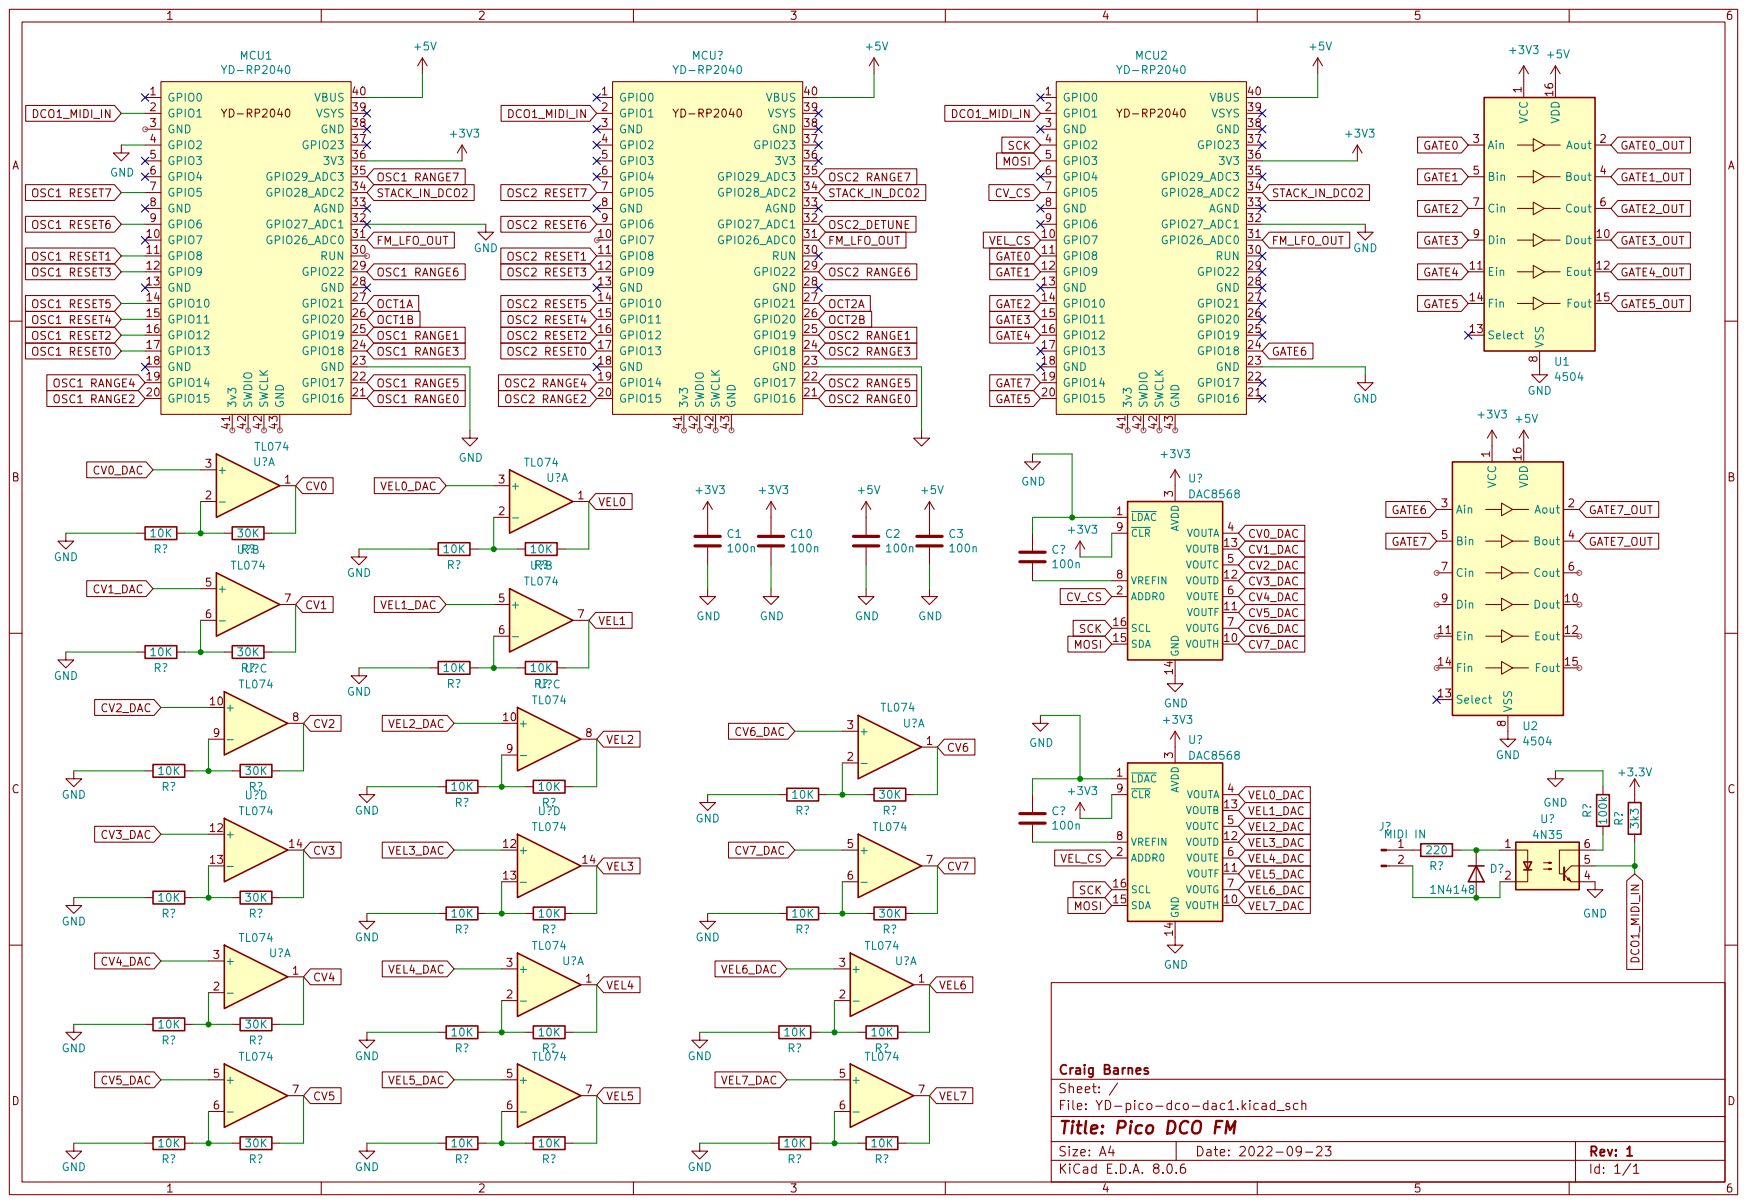
[picture p45: page 1]
