craigyjp/PolyKit-16/Schematics/level conversion.pdf

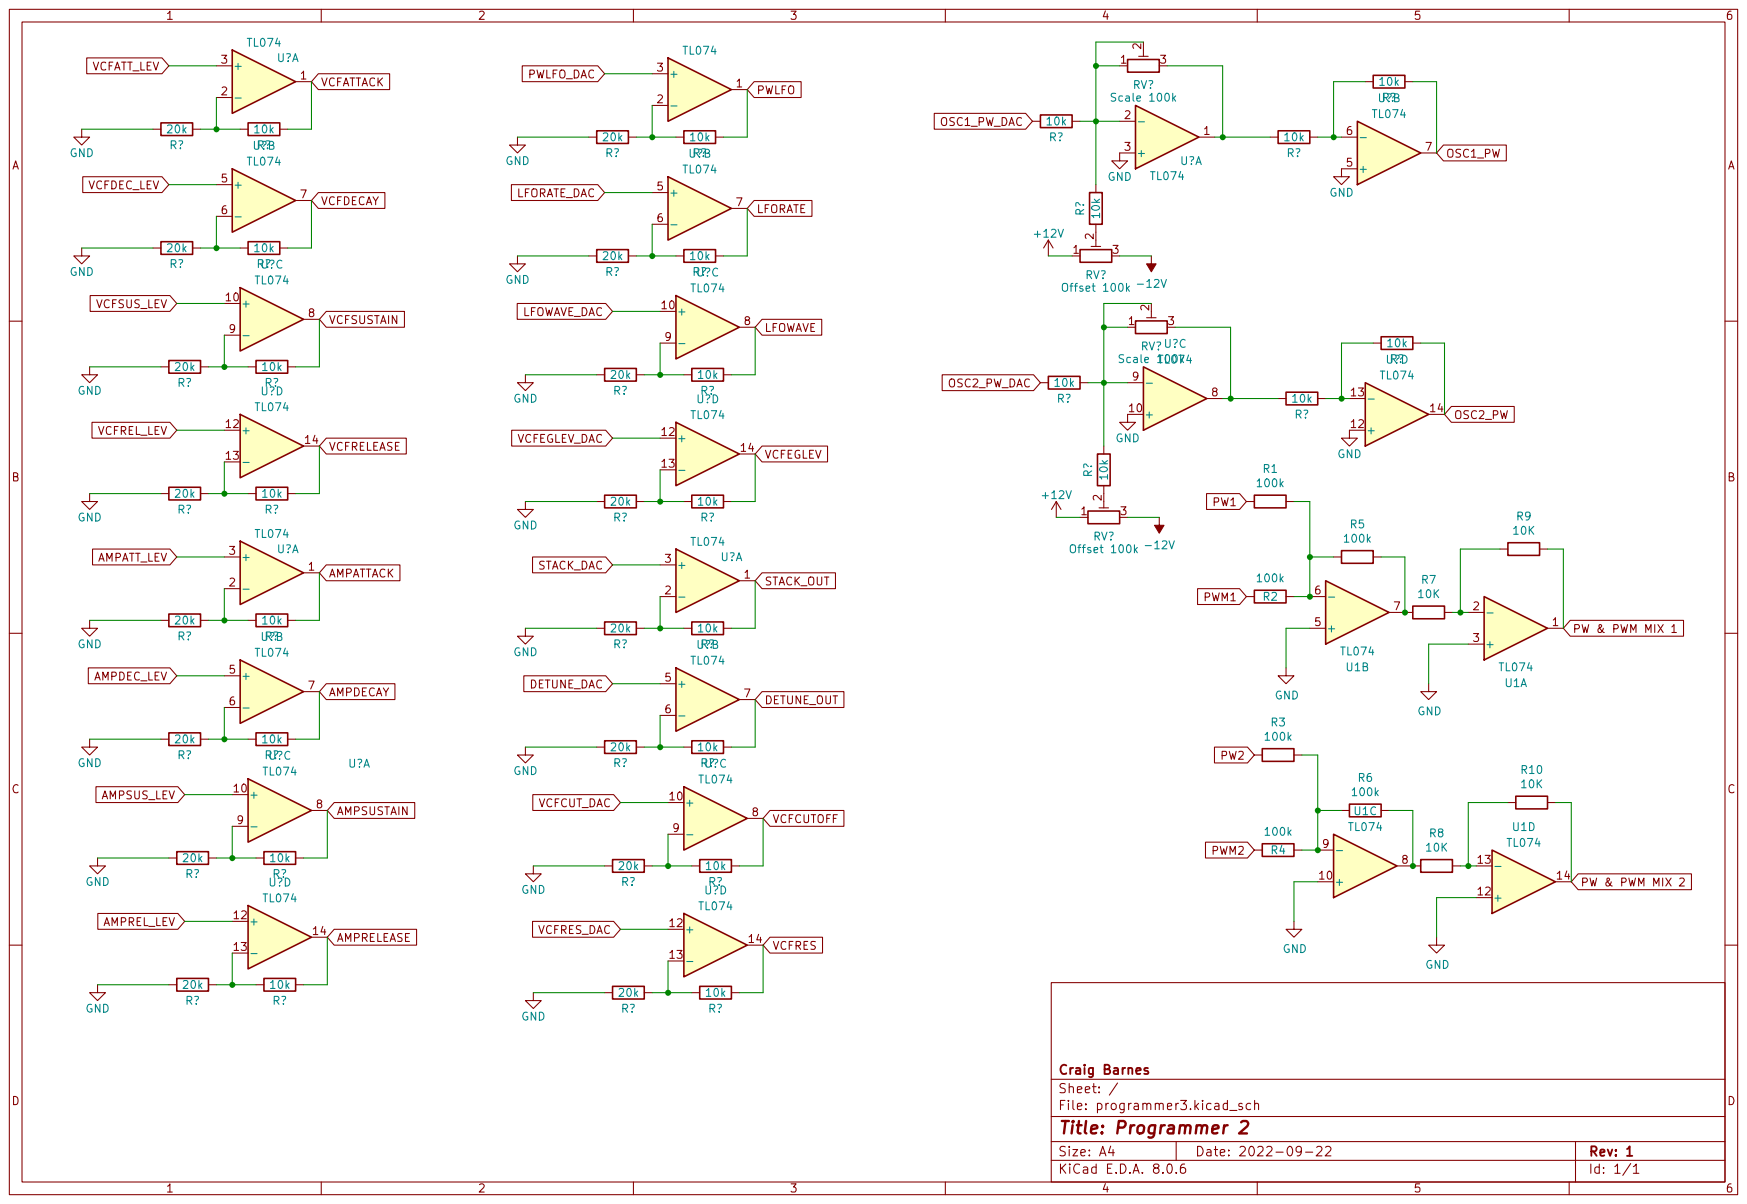
[picture p46: page 1]
