craigyjp/PolyKit-16/Schematics/Noise.pdf

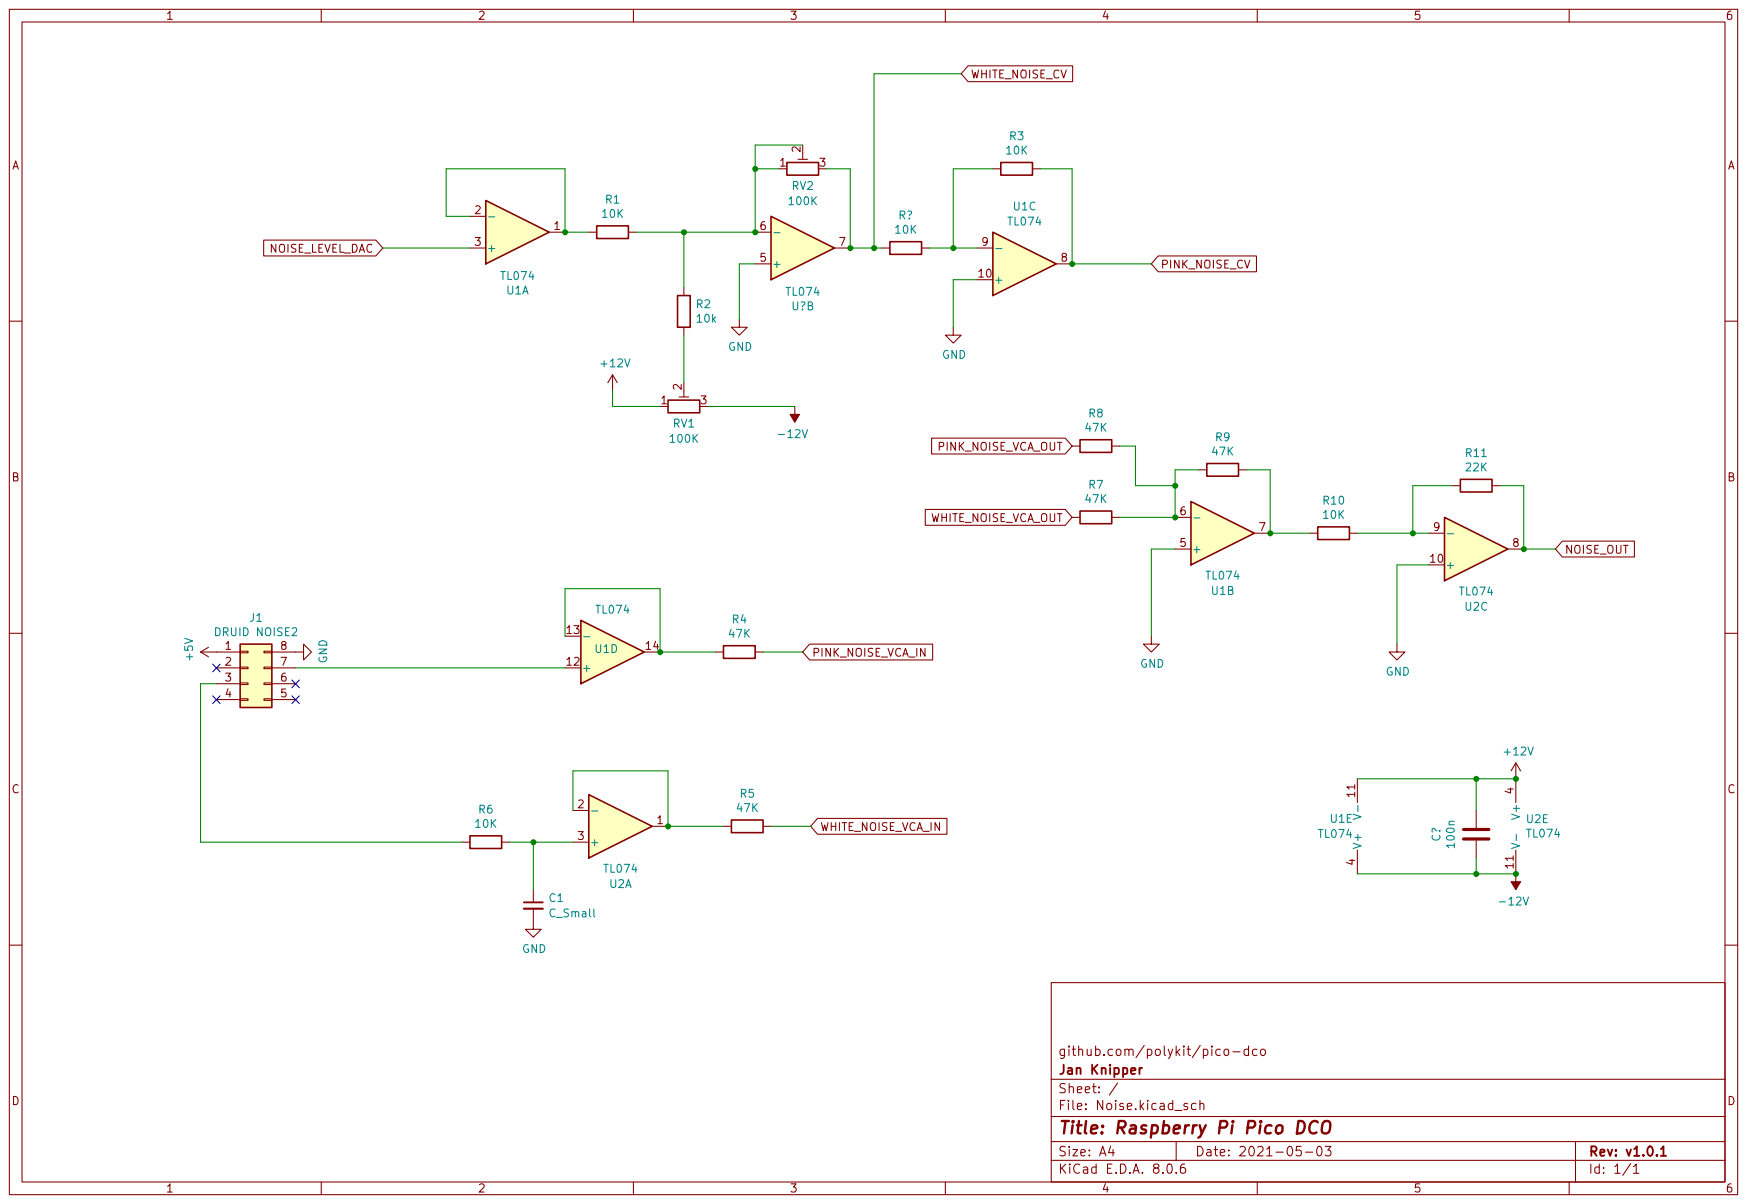
[picture p47: page 1]
