craigyjp/PolyKit-16/Schematics/sample_hold.pdf

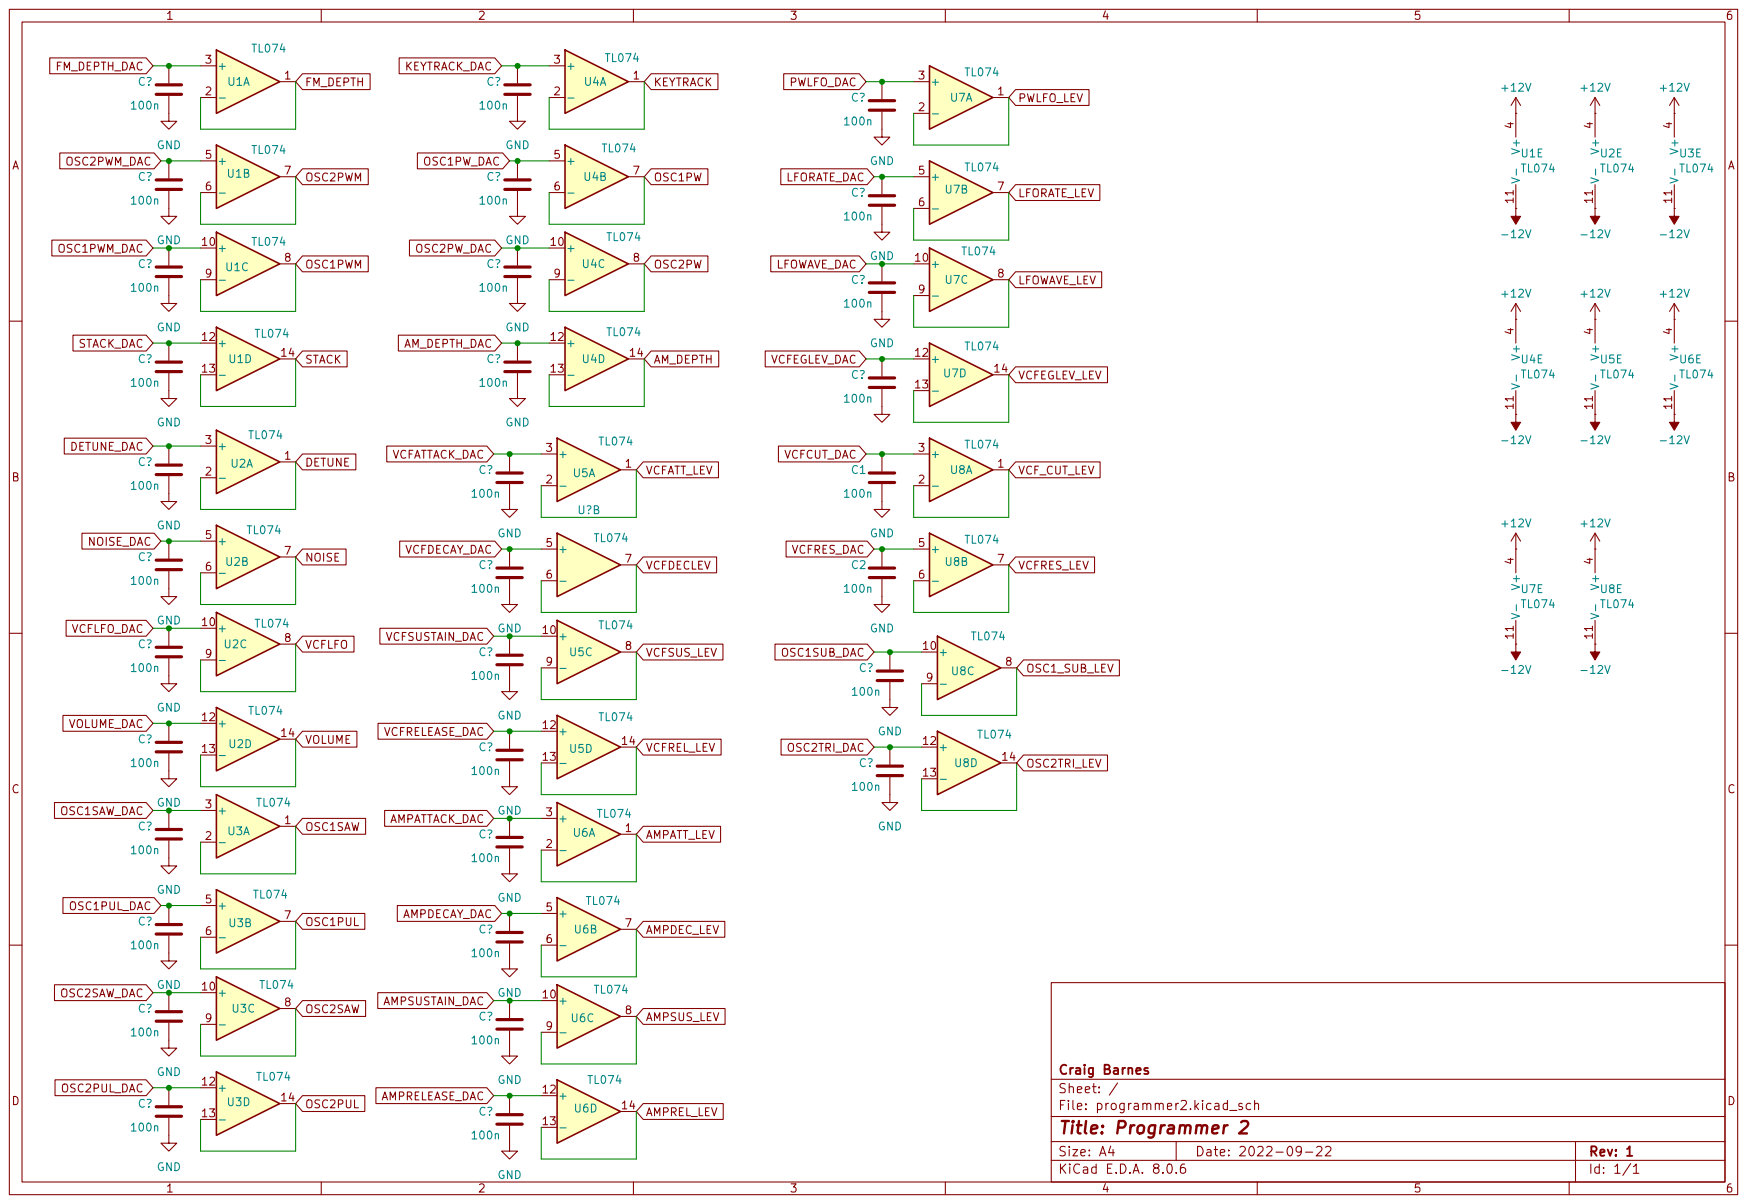
[picture p48: page 1]
