craigyjp/PolyKit-16/Schematics/filter-control.pdf

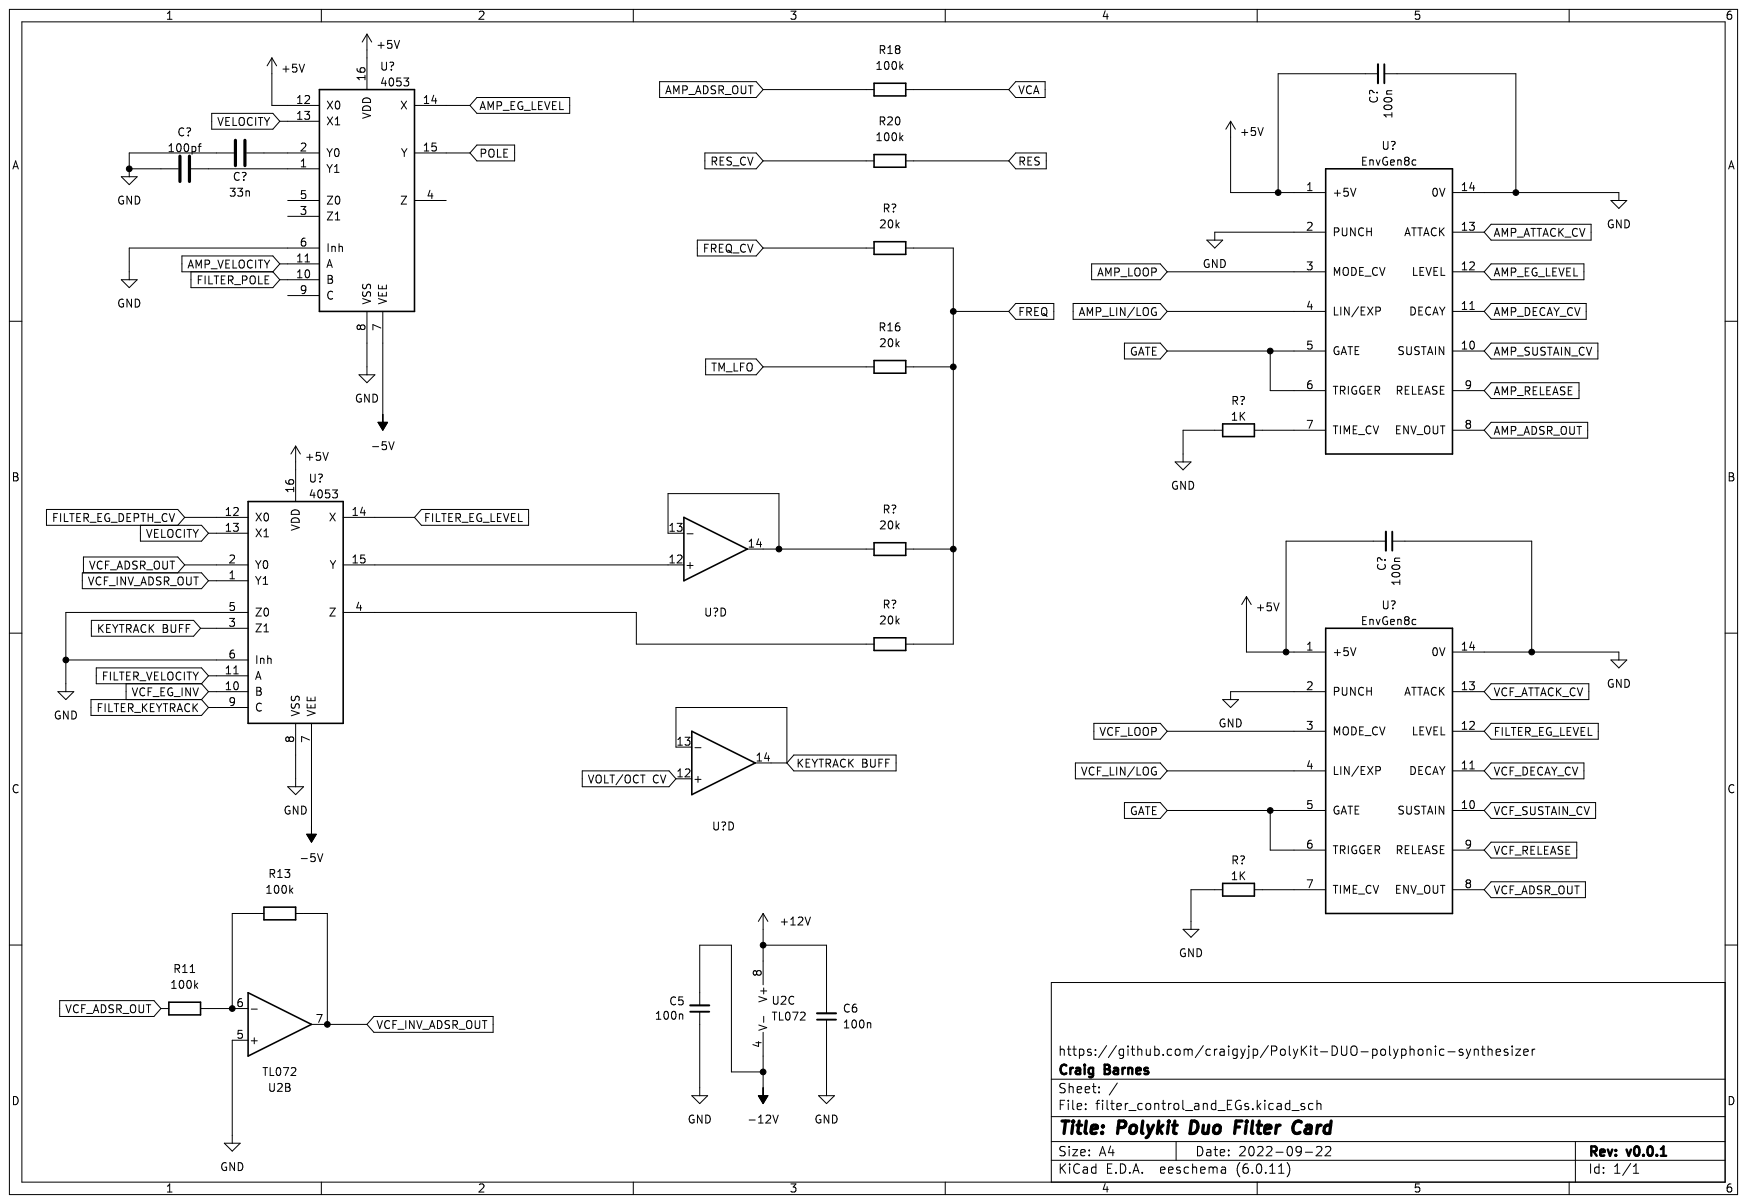
[picture p49: page 1]
