craigyjp/PolyKit-16/Schematics/pico-dco-dac.pdf

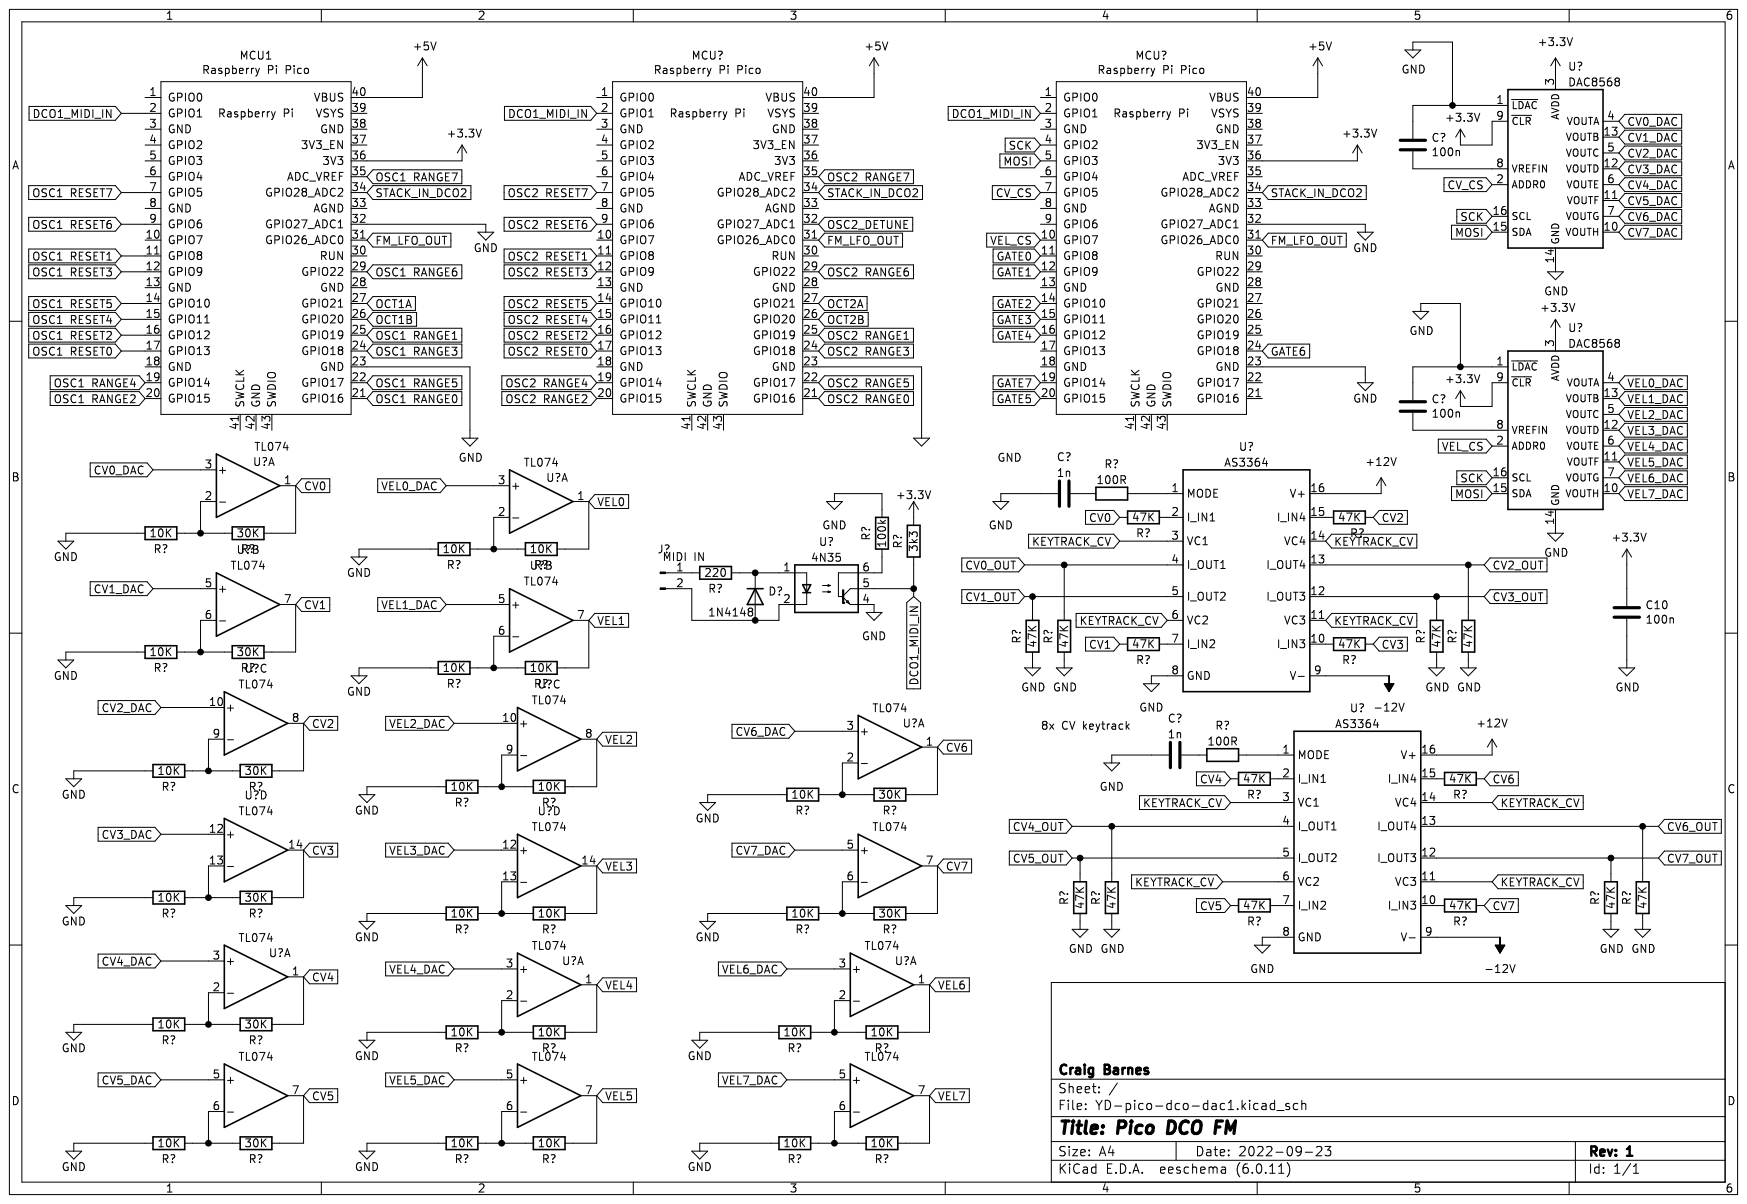
[picture p50: page 1]
