craigyjp/PolyKit-16/Schematics/Final VCA.pdf

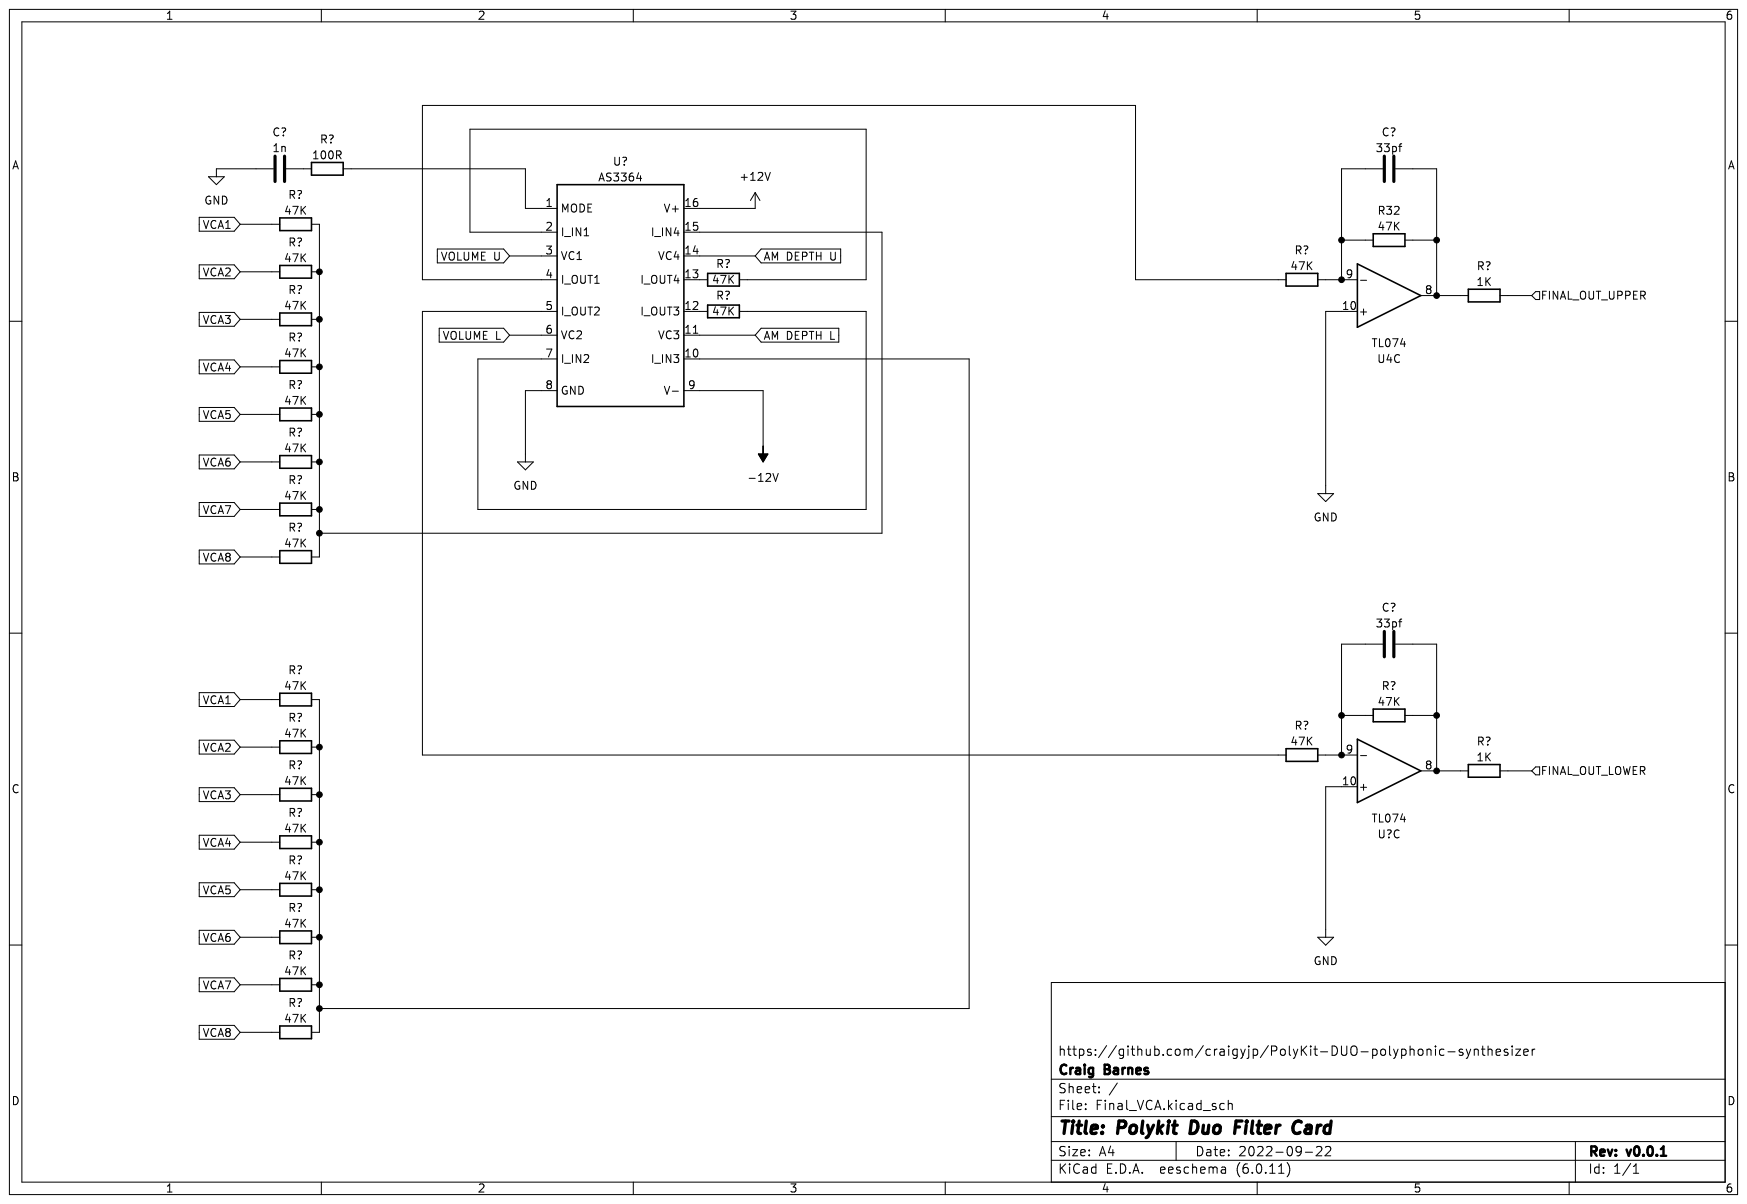
[picture p51: page 1]
