craigyjp/PolyKit-16/Schematics/DCO analogue board.pdf

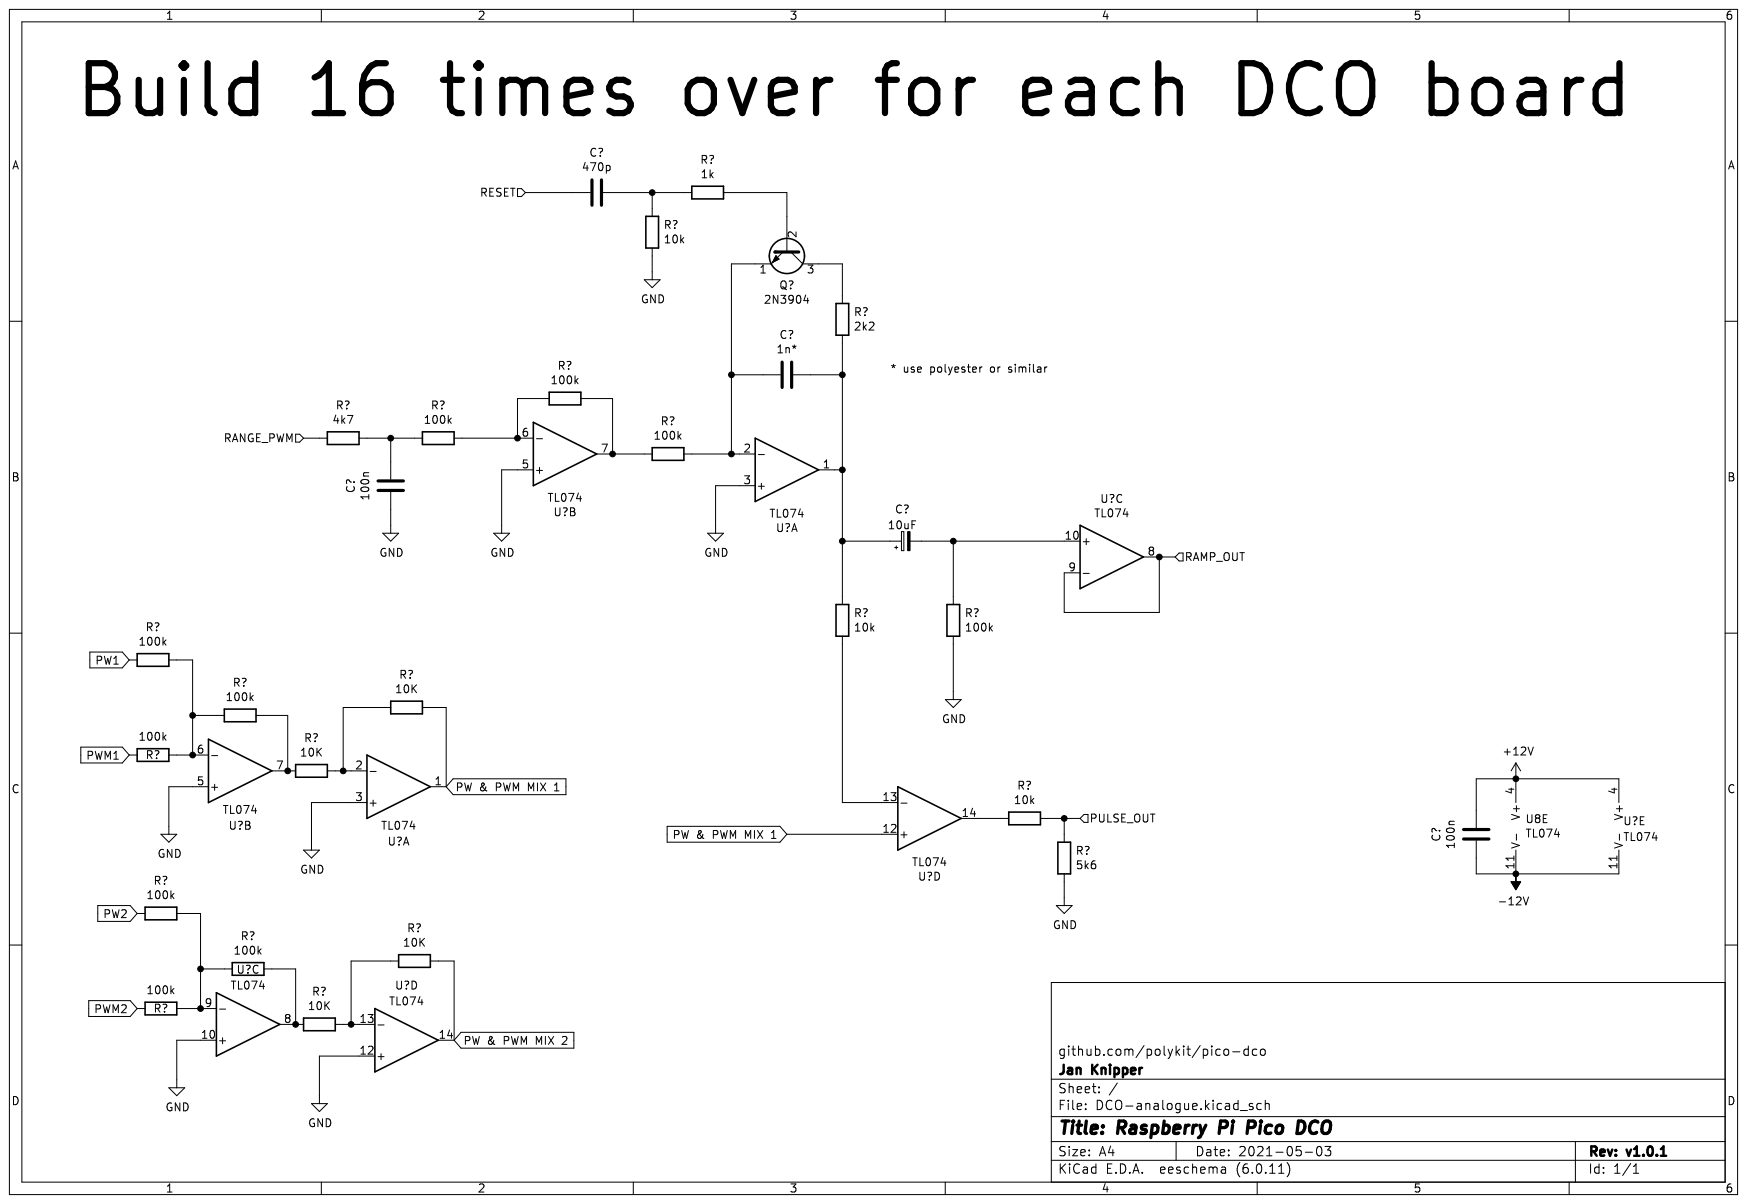
[picture p52: page 1]
