craigyjp/PolyKit-16/Schematics/filter-AS3372.pdf

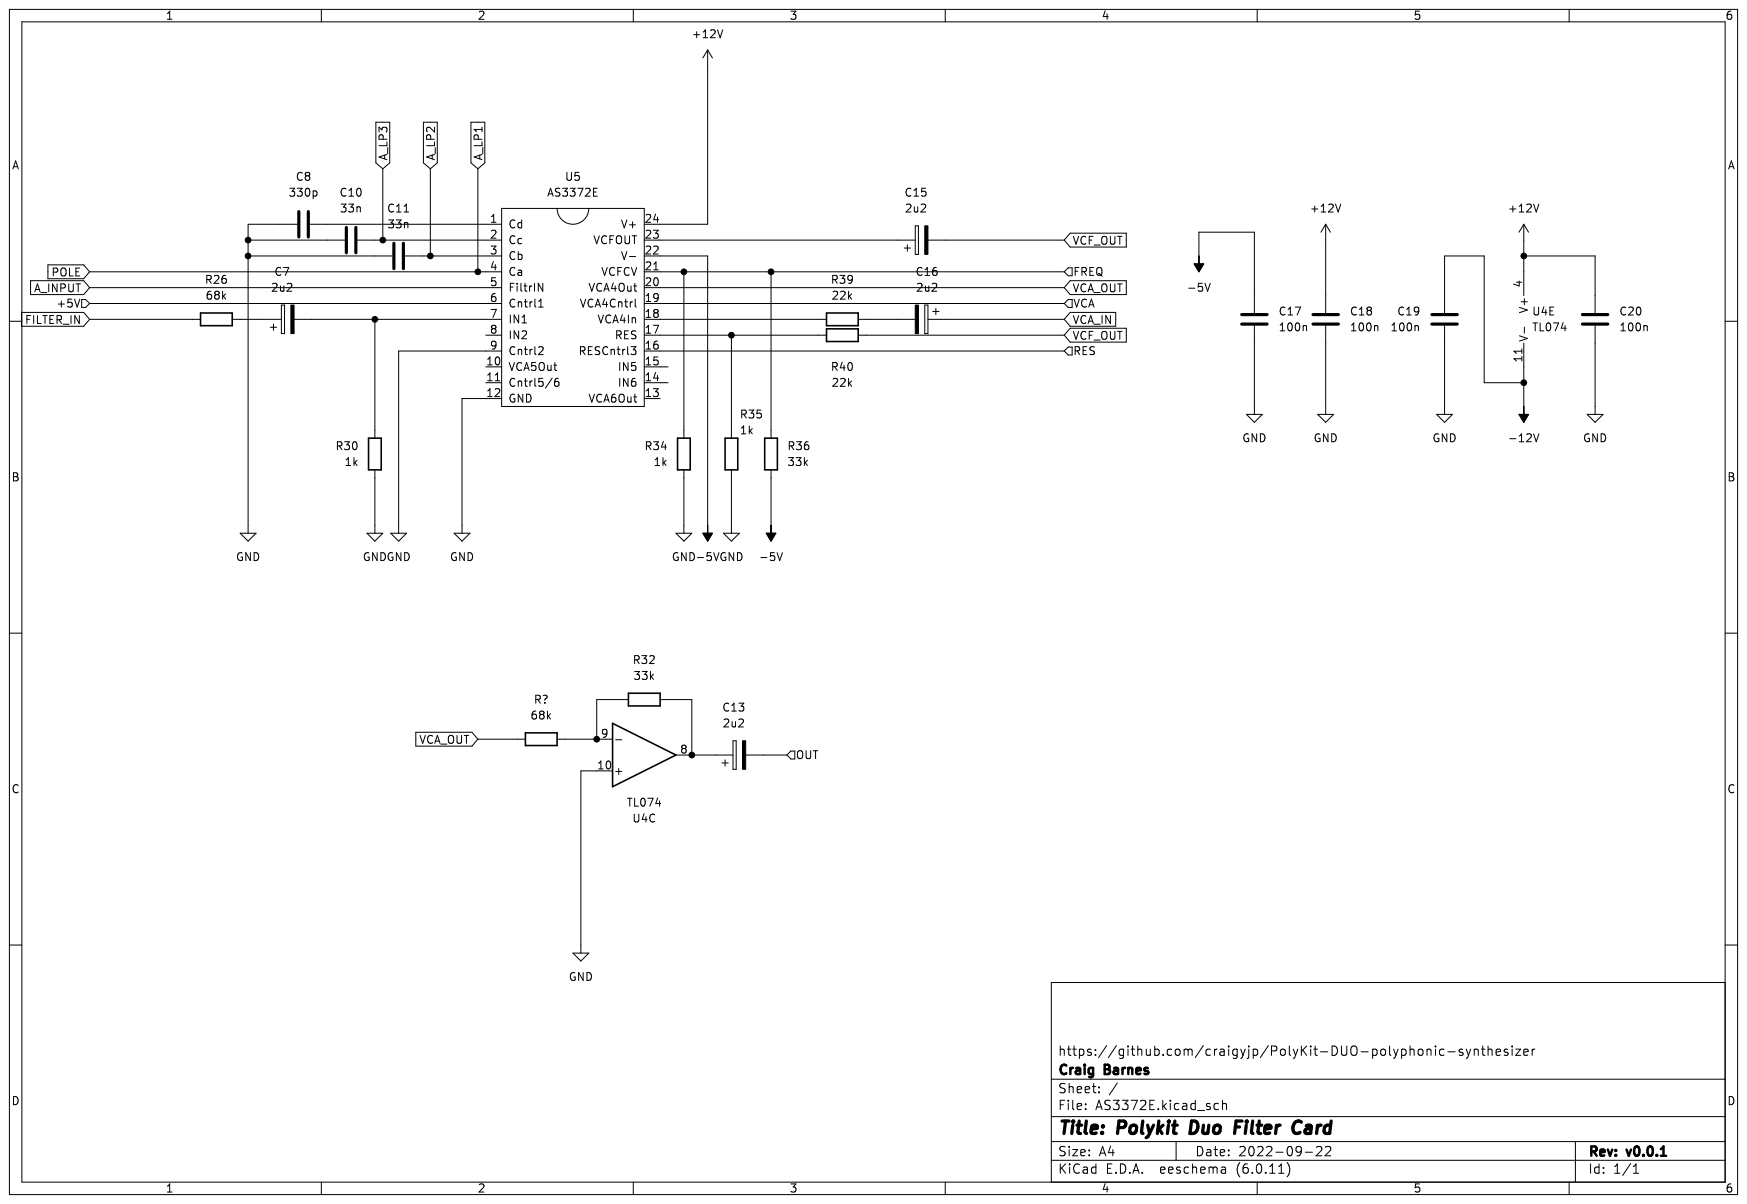
[picture p53: page 1]
