craigyjp/PolyKit-16/Constants.h

const char* VERSION = "V1.9";
const float FILTERCUTOFF[128] = {20, 23, 26, 29, 32, 36, 40, 46, 53, 60, 69, 78, 87, 98, 109, 120, 132, 145, 157, 171, 186, 200, 215, 231, 247, 264, 282, 300, 319, 338, 357, 378, 399, 421, 444, 467, 491, 516, 541, 567, 594, 621, 650, 680, 710, 741, 774, 806, 841, 876, 912, 949, 987, 1027, 1068, 1110, 1152, 1196, 1242, 1290, 1338, 1388, 1439, 1491, 1547, 1603, 1661, 1723, 1783, 1843, 1915, 1975, 2047, 2119, 2191, 2263, 2347, 2419, 2503, 2587, 2683, 2767, 2863, 2959, 3055, 3163, 3259, 3367, 3487, 3595, 3715, 3835, 3967, 4099, 4231, 4363, 4507, 4663, 4807, 4963, 5131, 5287, 5467, 5635, 5815, 6007, 6199, 6403, 6607, 6823, 7039, 7267, 7495, 7735, 7987, 8239, 8503, 8779, 9055, 9343, 9643, 9955, 10267, 10603, 10939, 11287, 11647, 12000};
const float ENVTIMES[128] = {1, 2, 4, 6, 9, 14, 20, 26, 33, 41, 49, 58, 67, 78, 89, 99, 111, 124, 136, 150, 164, 178, 192, 209, 224, 241, 258, 276, 295, 314, 333, 353, 374, 395, 418, 440, 464, 489, 513, 539, 565, 592, 621, 650, 680, 710, 742, 774, 808, 843, 878, 915, 952, 991, 1031, 1073, 1114, 1158, 1202, 1250, 1297, 1346, 1396, 1448, 1502, 1558, 1614, 1676, 1735, 1794, 1864, 1923, 1994, 2065, 2136, 2207, 2289, 2360, 2443, 2525, 2620, 2702, 2797, 2891, 2985, 3092, 3186, 3292, 3410, 3516, 3634, 3752, 3882, 4012, 4142, 4272, 4413, 4567, 4708, 4862, 5027, 5180, 5357, 5522, 5699, 5888, 6077, 6278, 6478, 6691, 6903, 7127, 7351, 7587, 7835, 8083, 8343, 8614, 8885, 9169, 9464, 9770, 10077, 10408, 10738, 11080, 11434, 11700};
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
#define RE_READ -9
#define NO_OF_VOICES 8
#define NO_OF_PARAMS 70
const char* INITPATCHNAME = "Initial Patch";
#define INITPERFORMANCENAME "New Perf"
#define HOLD_DURATION 1000
const uint32_t CLICK_DURATION = 250;
#define PATCHES_LIMIT 999
#define PERFORMANCE_LIMIT 128

const String INITPATCH = "Solina,1,1,1,1,1,1,1,1,1,10,1,1,1,1,1,1,1,1,1,10,1,1,1,1,1,1,1,1,1,10,1,1,1,1,1,1,1,1,1,10,1,1,1,1,1,1,1";
