craigyjp/PolyKit-16/(commit log)

2023-02-05 Latest schematics
    Still some more changes to make to the schematics as these were taken from the PolyKit DUO and need to be updated for the Polykit 16 layout.
2023-02-05 added buttons and pots
2023-02-06 Added MIDI and fixed pin DCO names
2023-02-06 Added missing 68k resistor in VCA output
2023-02-20 Fixed Sub and PWM
    Added a bipolar to unipolar converter to fix the sub oscillator inputs and combined the PW and PWM into common signals for each bank of 8 DCO's for greater tuning flexibility.
2023-02-20 corrected resistor values
2023-03-07 Fixed up more of the bi-timbral functions
    Added loading and saving, renaming of patches.
    [EepromMgr.h, Parameters.h, PolyKit16.ino, ST7735Display.h, Settings.h]
2023-03-07 Fixed lin/log envelope selection
    [PolyKit16.ino]
2023-03-14 Fixed whole mode to 16 voices
    [Constants.h, EepromMgr.h, HWControls.h, MidiCC.h, Parameters.h, PolyKit16.ino, ST7735Display.h, Settings.h]
2023-03-16 Fixed synth startup and more Wholemode work
    Occasionally the synth DCO's did not startup correctly, usually when the octave range was left in the 32' position. Now it's forced to 16' and notes are sent to initialize the DCO's before a voice is recalled.
    [EepromMgr.h, HWControls.h, MidiCC.h, Parameters.h, PolyKit16.ino, ST7735Display.h, Settings.h]
2023-03-18 Fixed more of the whole mode
    [PolyKit16.ino, ST7735Display.h]
2023-03-20 Added AM Depth to the schematics and the final VCA
2023-03-23 Updated DEMUX routine
    Fixed the glitchy writing of the DEMUX to a smoother output and lesss clock cycles required to write 64 values.
    [HWControls.h, PolyKit16.ino]
2023-03-24 Fixed the looping modes
    [Parameters.h, PolyKit16.ino]
2023-03-27 Fixed filter aftertouch and added AM aftertouch
    Filter aftertouch was crazy, pushing values bigger than 4095 to the DAC, controlled how aftertouch and Fc are added together not to exceed 4095. Also added the option for AM aftertouch.
    [EepromMgr.h, HWControls.h, Parameters.h, PolyKit16.ino, Settings.h]
2023-04-10 Updates to schematics
2023-04-10 Fixed LFO delay sustain after note release
    When the keys were lifted and the LFO had kicked in the LFO cut off abruptly. Now the LFO continues at its depth and is reset when new notes are issued.
    [PolyKit16.ino]
2024-11-09 Added noise schematic
2024-11-09 Added channel 2 DAC board code
2024-11-10 Added AllNotesOff and fixed keytrack to immediate update
    [YD-dco-dac.c]
2024-11-10 Added AllNotesOff and fixed keytrack for immediate update
    [YD-dco-dac.c]
2024-11-12 Fixed strange demux behaviour
    [HWControls.h, PolyKit16.ino]
2024-11-13 fixed upper section demux updates
    [Constants.h, MidiCC.h, Parameters.h, PolyKit16.ino]
2025-04-30 Fixed lower patch location on screen
    [ST7735Display.h]
2025-05-03 Saving performances now works with the upper/lower button
